AL2TECH/Project_Template/Rev_1/Outputs/PCB_Assembly/LEOLED_rev1_3D_BOTTOM.jpg

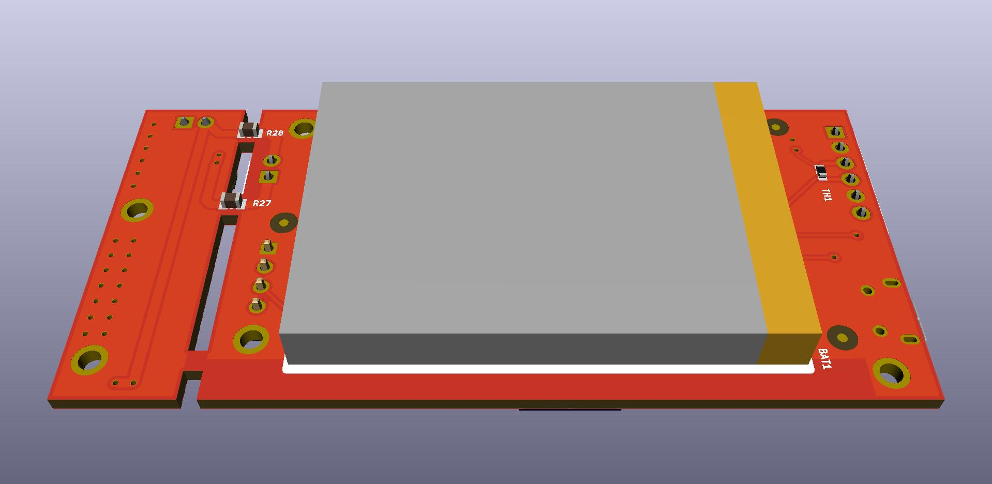
Rev_1/Outputs/PCB_Assembly/LEOLED_rev1_3D_BOTTOM.jpg
