AL2TECH/Project_Template/Rev_1/Outputs/PCB_Assembly/components_position_BOTTOM.csv

Reference | Package | X Position (mm) | Y Position (mm) | Rotation (Degrees) | Side
BAT1 | SMD | 37.03 | 21.33 | 0.0 | bottom
R27 | SMD | 71.0 | 24.7 | 0.0 | bottom
R28 | SMD | 70.9 | 35.9 | 0.0 | bottom
TH1 | SMD | 5.3 | 29.5 | 90.0 | bottom
