AL2TECH/Project_Template/Rev_1/Kicad/shapes3D/ABS07.step

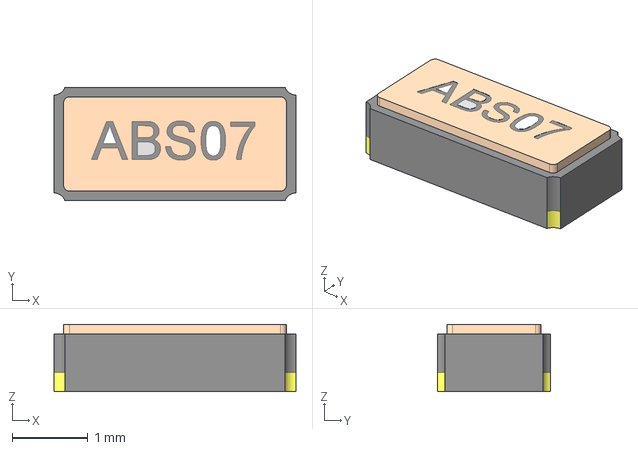
[picture p3: CAD file, 2019-05-30]
Rev_1/Kicad/shapes3D/ABS07.step
3.20 x 1.50 x 0.889 mm
