AL2TECH/Project_Template/Rev_1/Kicad/shapes3D/SOT-353_SC-70-5.step

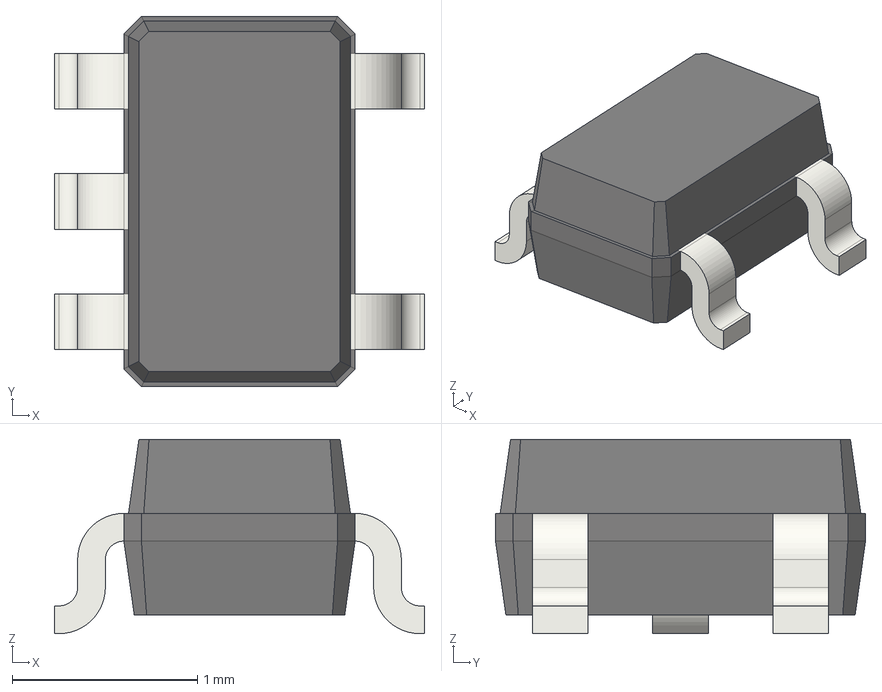
[picture p4: CAD file, 2019-05-30]
Rev_1/Kicad/shapes3D/SOT-353_SC-70-5.step
2.00 x 2.00 x 1.05 mm
