AL2TECH/Project_Template/Rev_1/Kicad/shapes3D/SOT-23-5.step

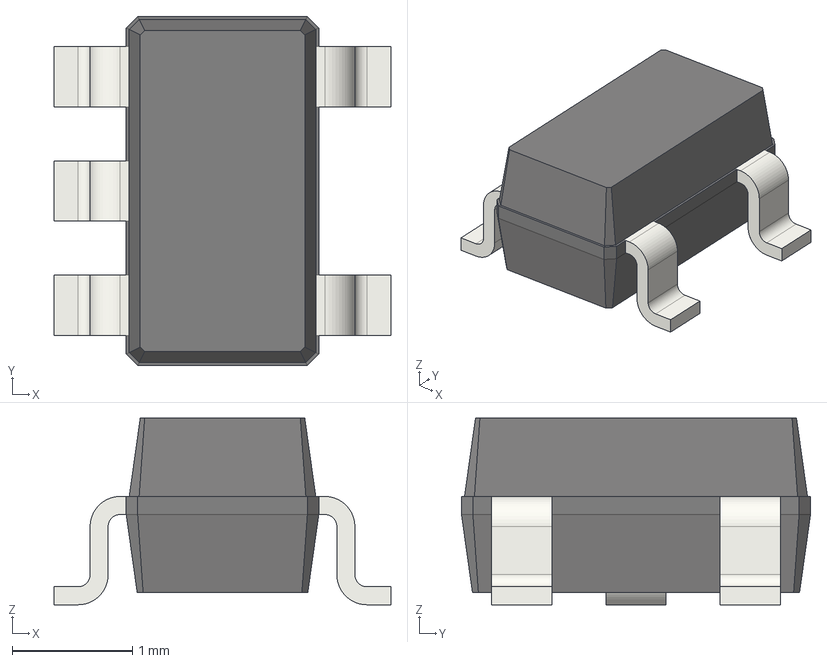
[picture p5: CAD file, 2019-05-30]
Rev_1/Kicad/shapes3D/SOT-23-5.step
2.80 x 2.90 x 1.55 mm
