AL2TECH/Project_Template/Rev_1/Kicad/shapes3D/D_SOD-123F.step

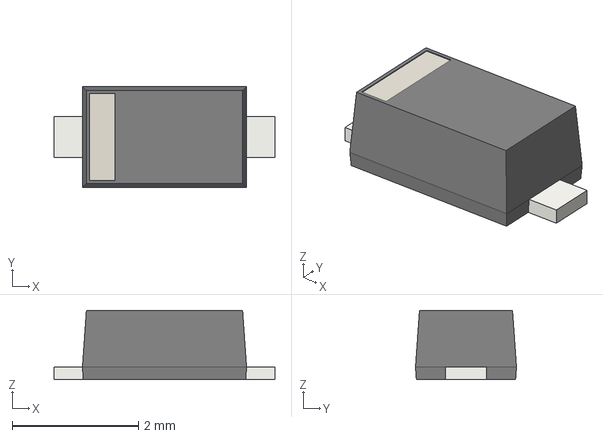
[picture p6: CAD file, 2019-05-30]
Rev_1/Kicad/shapes3D/D_SOD-123F.step
3.50 x 1.60 x 1.10 mm
