AL2TECH/Project_Template/Rev_1/Kicad/shapes3D/R_0603_1608Metric.step

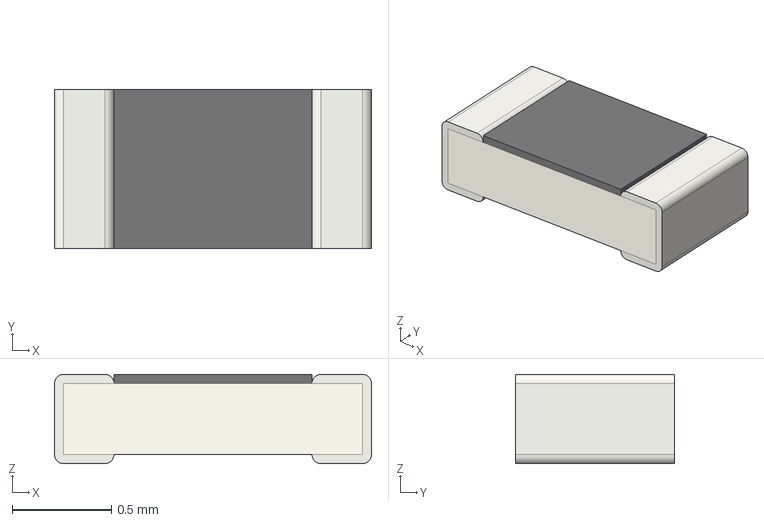
[picture p7: CAD file, 2019-05-30]
Rev_1/Kicad/shapes3D/R_0603_1608Metric.step
1.60 x 0.8 x 0.45 mm
