AL2TECH/Project_Template/Rev_1/Kicad/shapes3D/Lithium_battery_50x30x5.3.step

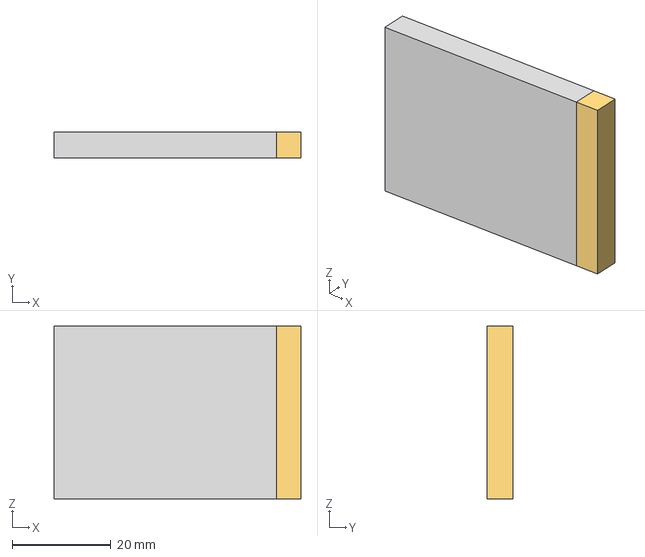
[picture p8: CAD file, 2019-05-30]
Rev_1/Kicad/shapes3D/Lithium_battery_50x30x5.3.step
50.0 x 5.30 x 35.0 mm
