AL2TECH/Project_Template/Rev_1/Kicad/shapes3D/C_1206_3216Metric.step

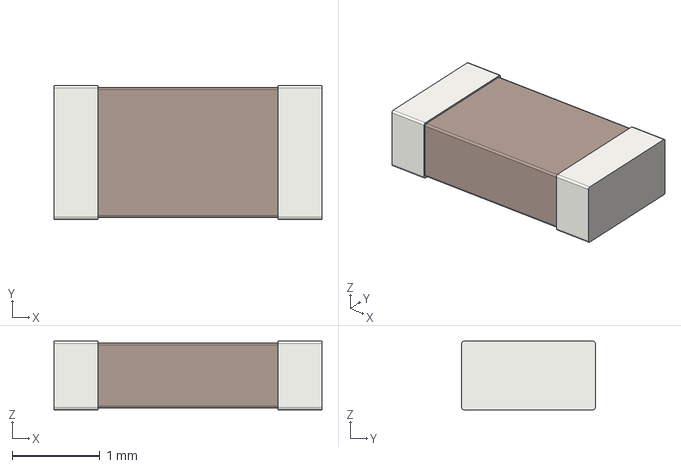
[picture p9: CAD file, 2019-05-30]
Rev_1/Kicad/shapes3D/C_1206_3216Metric.step
3.05 x 1.52 x 0.78 mm
