AL2TECH/Project_Template/Rev_1/Kicad/shapes3D/C_0805_2012Metric.step

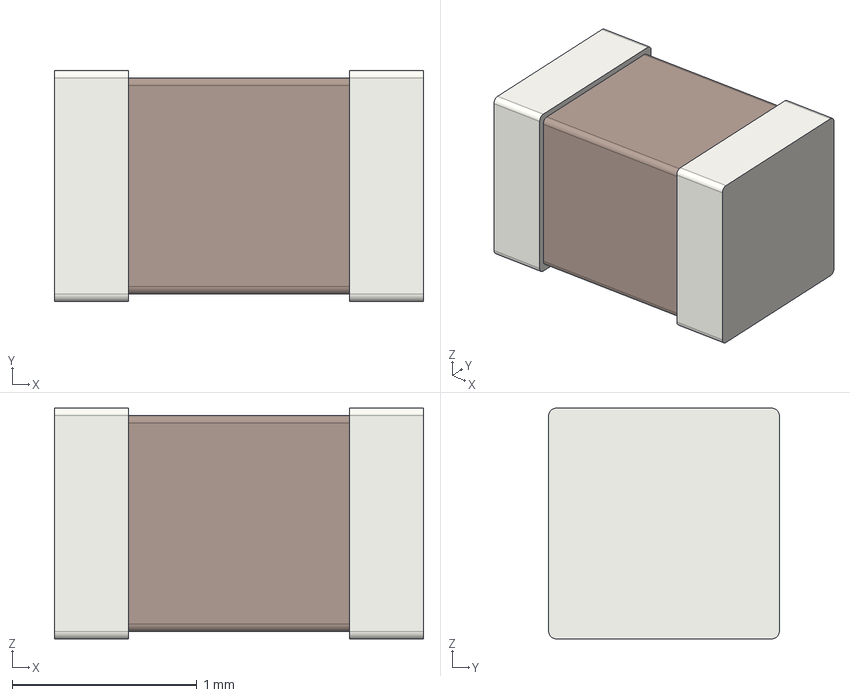
[picture p11: CAD file, 2019-05-30]
Rev_1/Kicad/shapes3D/C_0805_2012Metric.step
2.00 x 1.25 x 1.25 mm
