AL2TECH/Project_Template/Rev_1/Kicad/shapes3D/WSON-20_2x3mm.step

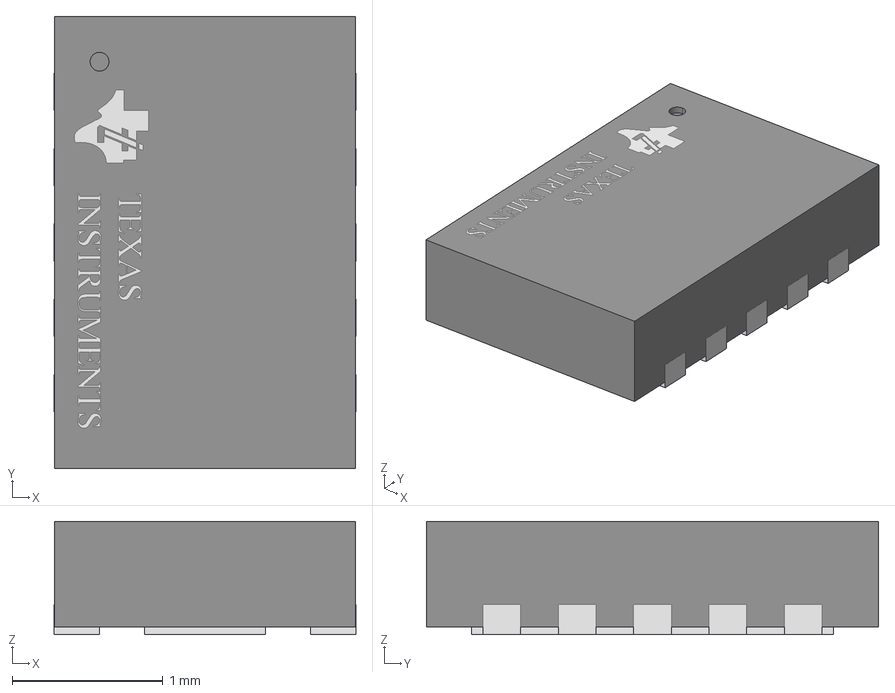
[picture p12: CAD file, 2019-05-30]
Rev_1/Kicad/shapes3D/WSON-20_2x3mm.step
2.00 x 3.00 x 0.75 mm
