AL2TECH/Project_Template/Rev_1/Kicad/shapes3D/LED_0603_Side_Mounted.step

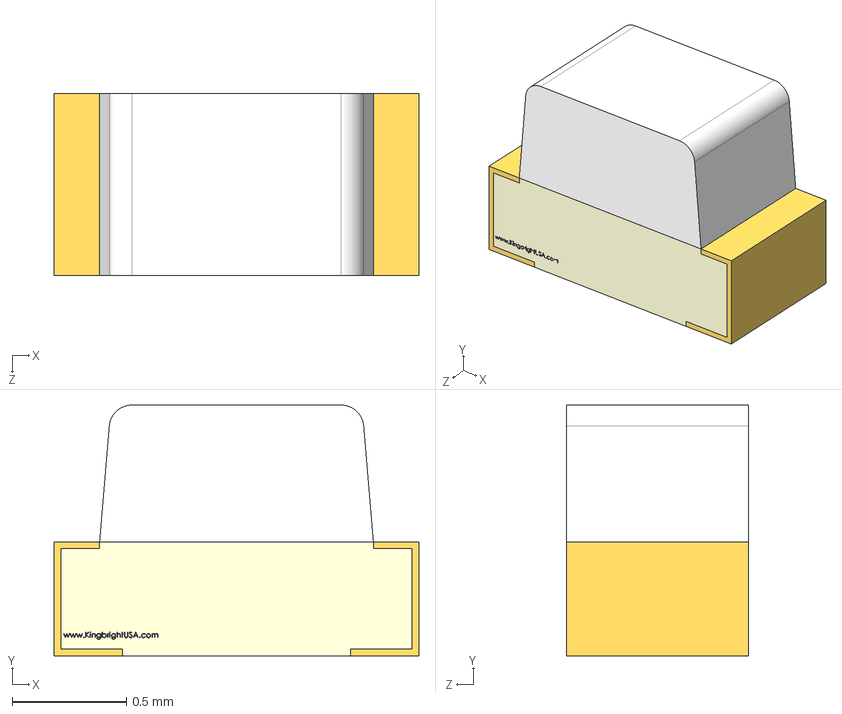
[picture p14: CAD file, 2019-05-30]
Rev_1/Kicad/shapes3D/LED_0603_Side_Mounted.step
1.60 x 1.10 x 0.8 mm
