AL2TECH/Project_Template/Rev_1/Kicad/shapes3D/C_0402_1005Metric.step

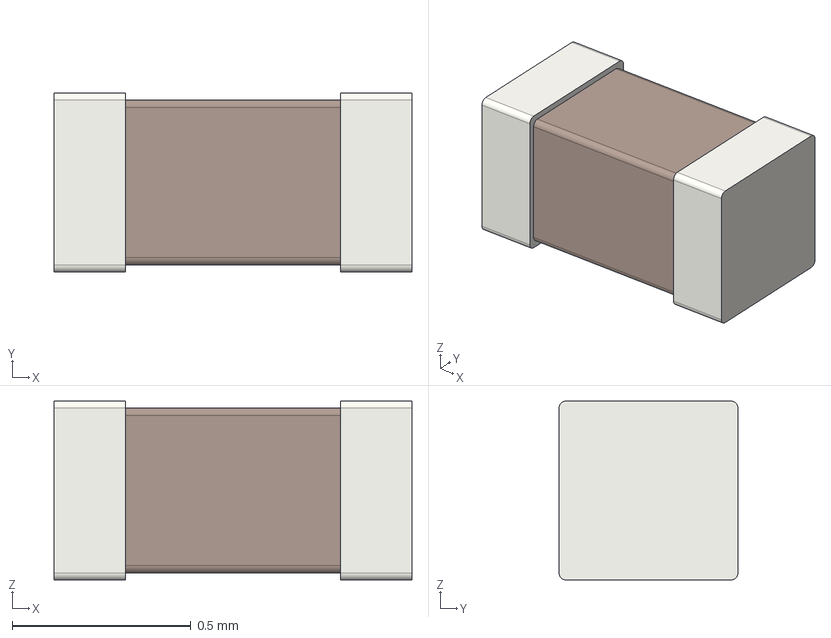
[picture p15: CAD file, 2019-05-30]
Rev_1/Kicad/shapes3D/C_0402_1005Metric.step
1.00 x 0.5 x 0.5 mm
