AL2TECH/Project_Template/Rev_1/Kicad/shapes3D/Pin_Header_Straight_2x05_Pitch1.27mm_SMD.step

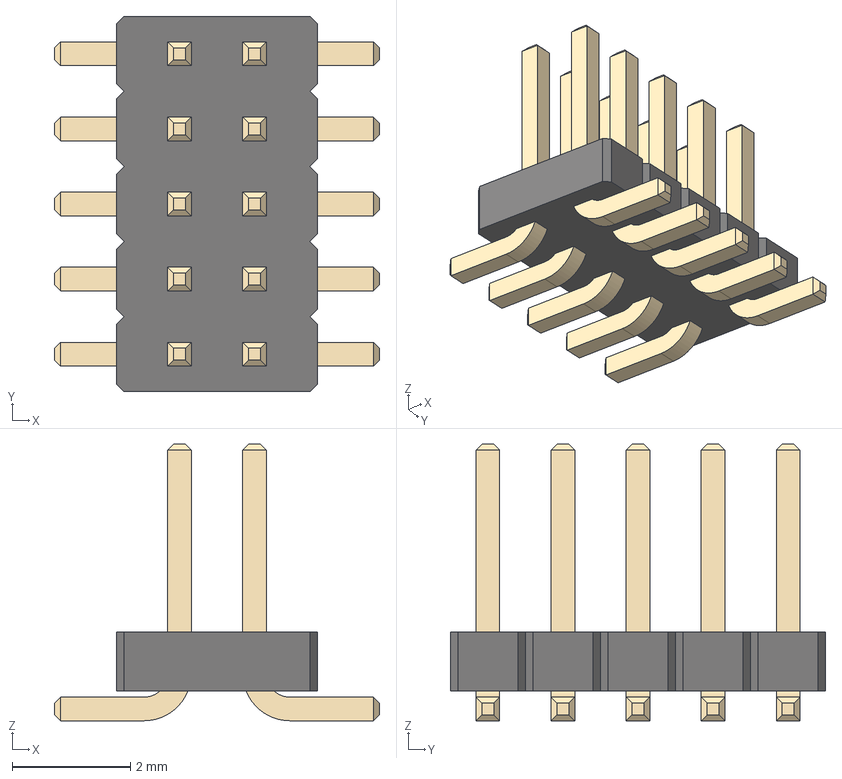
[picture p16: CAD file, 2019-05-30]
Rev_1/Kicad/shapes3D/Pin_Header_Straight_2x05_Pitch1.27mm_SMD.step
5.50 x 6.35 x 4.68 mm
