AL2TECH/Project_Template/Rev_1/Kicad/shapes3D/L_Wurth_5030.step

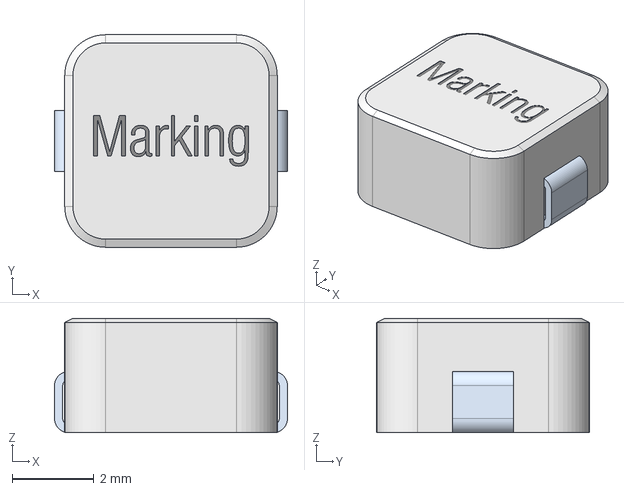
[picture p17: CAD file, 2019-05-30]
Rev_1/Kicad/shapes3D/L_Wurth_5030.step
5.70 x 5.20 x 2.80 mm
