AL2TECH/Project_Template/Rev_1/Kicad/shapes3D/Pin_Header_Straight_1x04_Pitch2.54mm.step

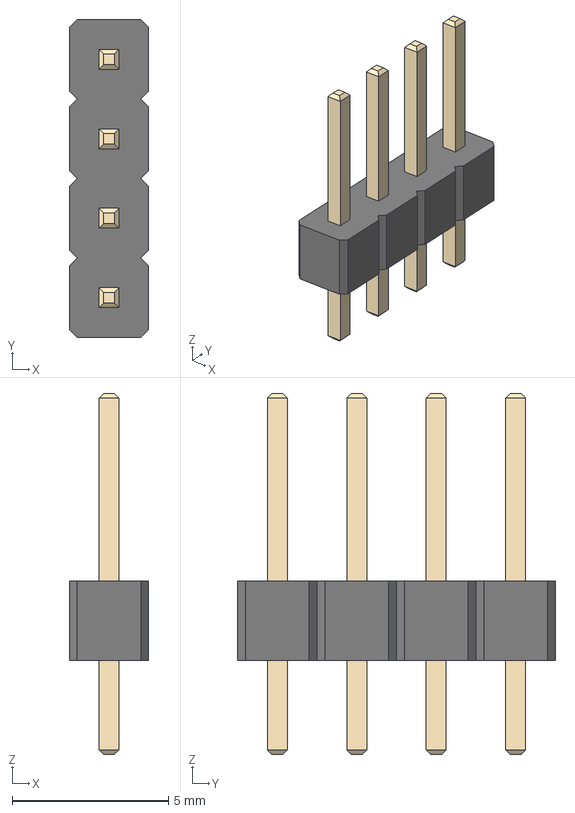
[picture p18: CAD file, 2019-05-30]
Rev_1/Kicad/shapes3D/Pin_Header_Straight_1x04_Pitch2.54mm.step
2.54 x 10.2 x 11.5 mm
