AL2TECH/Project_Template/Rev_1/Kicad/shapes3D/USB_Molex_1050170001.step

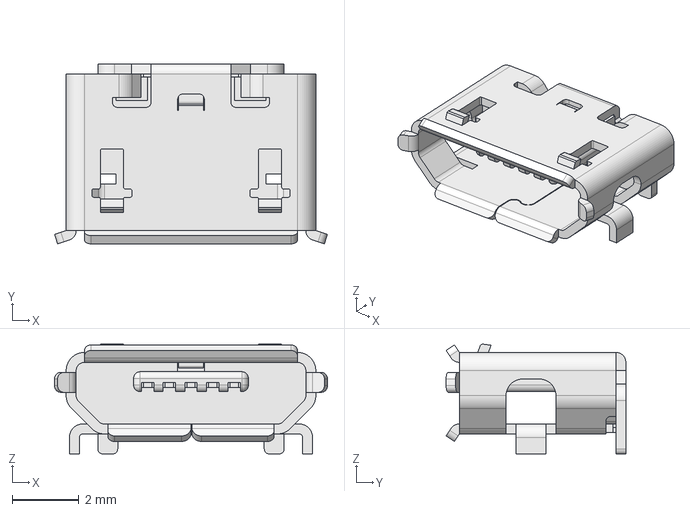
[picture p19: CAD file, 2019-05-30]
Rev_1/Kicad/shapes3D/USB_Molex_1050170001.step
8.20 x 5.40 x 3.30 mm
