AL2TECH/Project_Template/Rev_1/Kicad/shapes3D/Cree_XLM.step

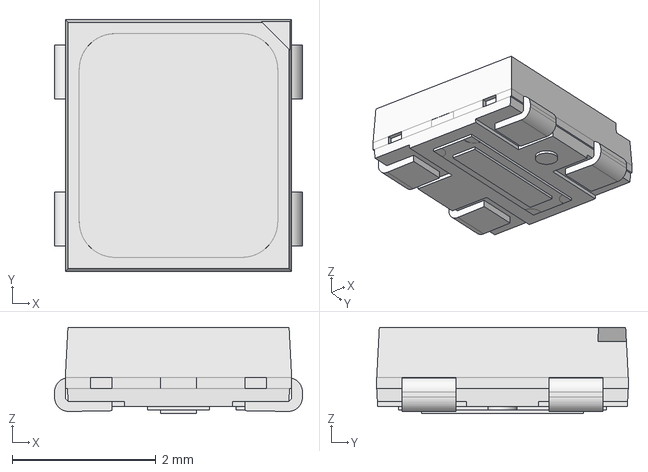
[picture p20: CAD file, 2019-05-30]
Rev_1/Kicad/shapes3D/Cree_XLM.step
3.45 x 3.50 x 1.20 mm
