AL2TECH/Project_Template/Rev_1/Outputs/PCB_Manufacturing/LEOLED_rev1-Fab_Drawings.pdf

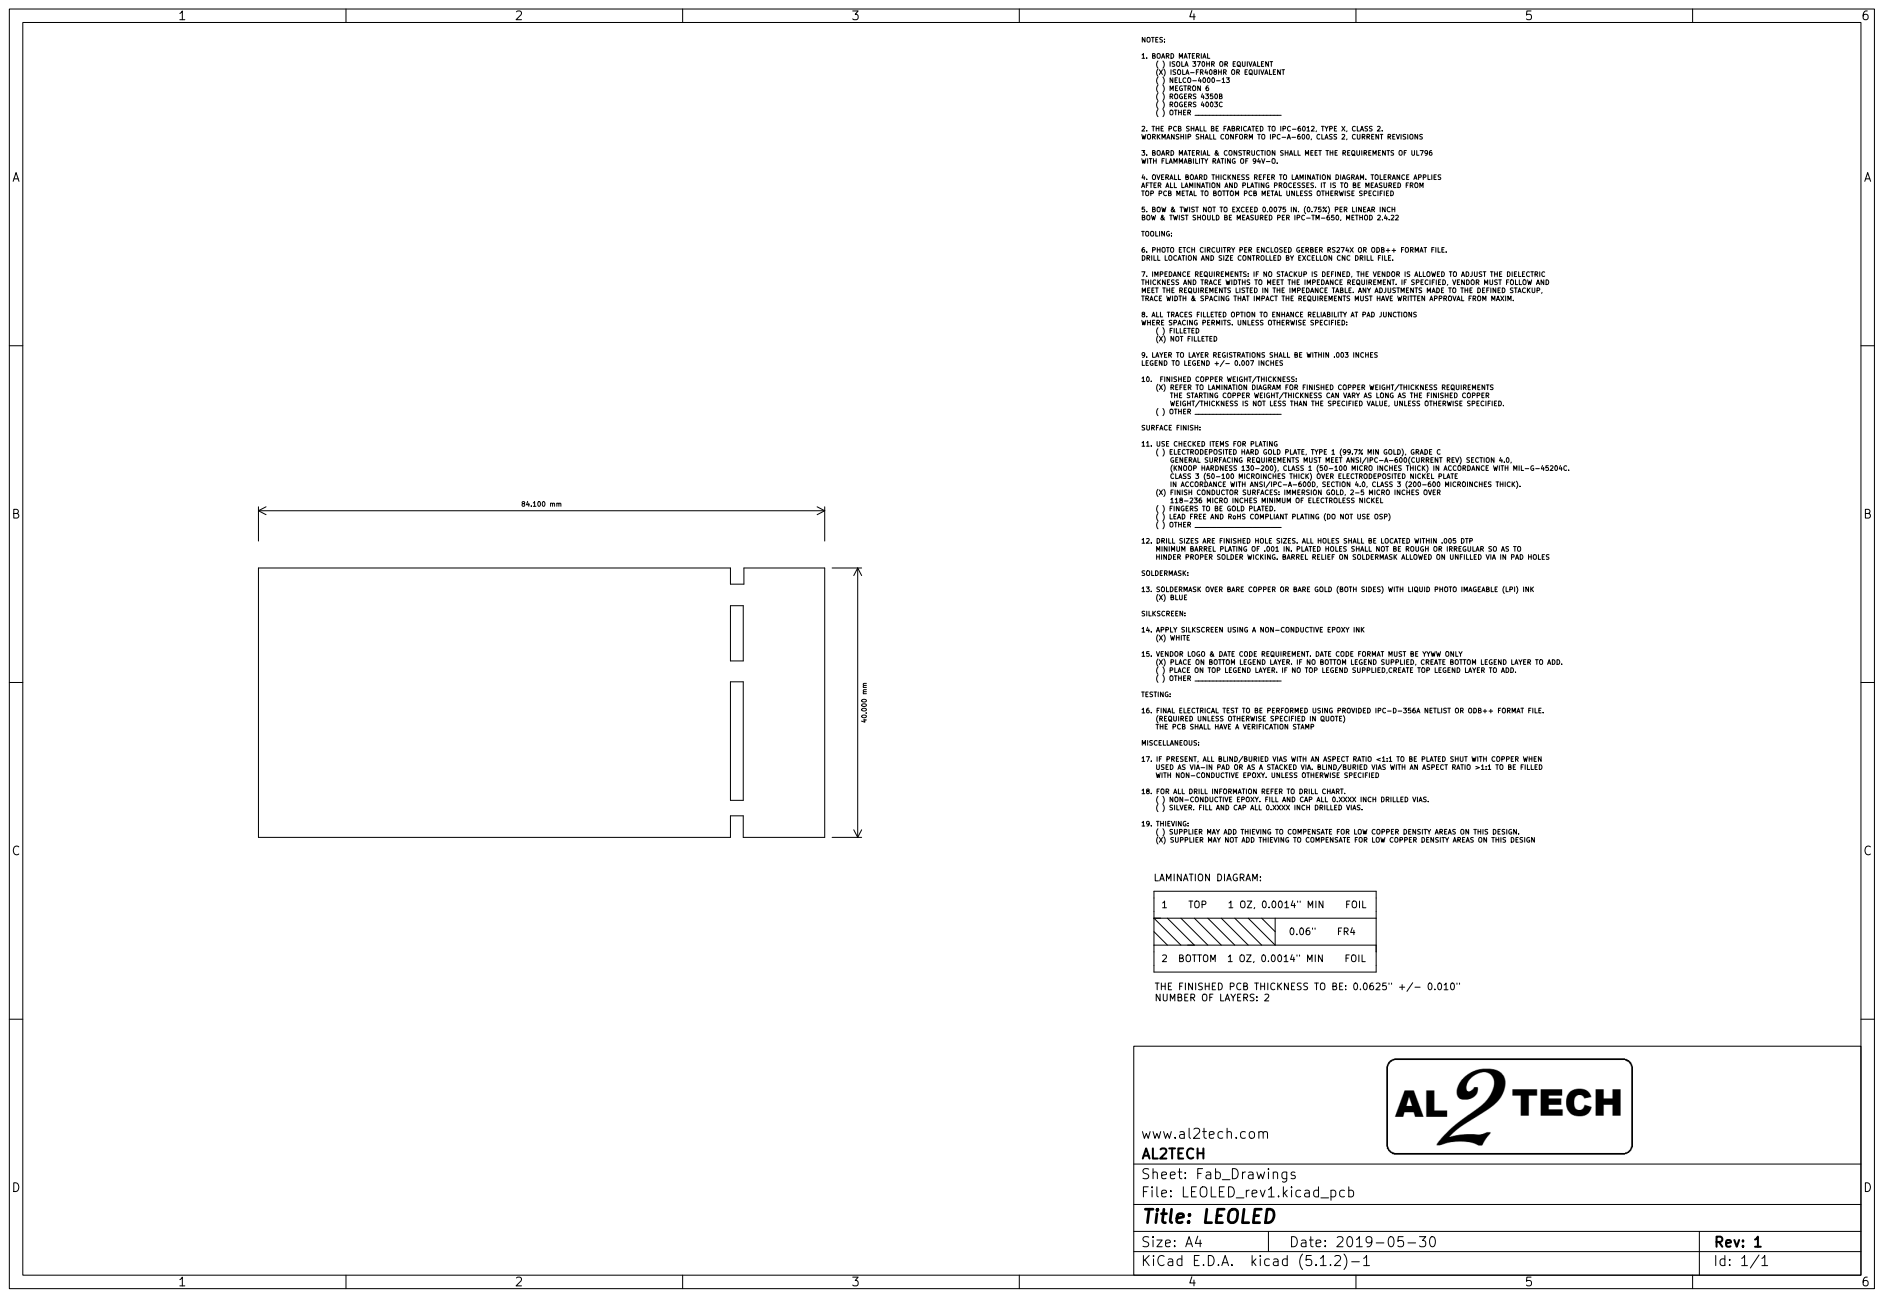
[picture p21: page 1]

2. THE PCB SHALL BE FABRICATED TO IPC-6012, TYPE X, CLASS 2. WORKMANSHIP SHALL CONFORM TO IPC-A-600, CLASS 2, CURRENT REVISIONS

3. BOARD MATERIAL & CONSTRUCTION SHALL MEET THE REQUIREMENTS OF UL796 WITH FLAMMABILITY RATING OF 94V-O. 4. OVERALL BOARD THICKNESS REFER TO LAMINATION DIAGRAM. TOLERANCE APPLIES AFTER ALL LAMINATION AND PLATING PROCESSES. IT IS TO BE MEASURED FROM

TOP PCB METAL TO BOTTOM PCB METAL UNLESS OTHERWISE SPECIFIED

5. BOW & TWIST NOT TO EXCEED 0.0075 IN. (0.75%) PER LINEAR INCH
BOW & TWIST SHOULD BE MEASURED PER IPC-TM-650, METHOD 2.4.22 TOOLING: 6. PHOTO ETCH CIRCUITRY PER ENCLOSED GERBER RS274X OR ODB++ FORMAT FILE. DRILL LOCATION AND SIZE CONTROLLED BY EXCELLON CNC DRILL FILE. 7. IMPEDANCE REQUIREMENTS: IF NO STACKUP IS DEFINED, THE VENDOR IS ALLOWED TO ADJUST THE DIELECTRIC

THICKNESS AND TRACE WIDTHS TO MEET THE IMPEDANCE REQUIREMENT. IF SPECIFIED, VENDOR MUST FOLLOW AND MEET THE REQUIREMENTS LISTED IN THE IMPEDANCE TABLE. ANY ADJUSTMENTS MADE TO THE DEFINED STACKUP, TRACE WIDTH & SPACING THAT IMPACT THE REQUIREMENTS MUST HAVE WRITTEN APPROVAL FROM MAXIM. 8. ALL TRACES FILLETED OPTION TO ENHANCE RELIABILITY AT PAD JUNCTIONS WHERE SPACING PERMITS. UNLESS OTHERWISE SPECIFIED:

9. LAYER TO LAYER REGISTRATIONS SHALL BE WITHIN .003 INCHES
LEGEND TO LEGEND +/- 0.007 INCHES

10. FINISHED COPPER WEIGHT/THICKNESS:
(X) REFER TO LAMINATION DIAGRAM FOR FINISHED COPPER WEIGHT/THICKNESS REQUIREMENTS
THE STARTING COPPER WEIGHT/THICKNESS CAN VARY AS LONG AS THE FINISHED COPPER
WEIGHT/THICKNESS IS NOT LESS THAN THE SPECIFIED VALUE, UNLESS OTHERWISE SPECIFIED.
( ) OTHER ________________________ SURFACE FINISH: 11. USE CHECKED ITEMS FOR PLATING

( ) ELECTRODEPOSITED HARD GOLD PLATE, TYPE 1 (99.7% MIN GOLD), GRADE C
GENERAL SURFACING REQUIREMENTS MUST MEET ANSI/IPC-A-600(CURRENT REV) SECTION 4.0,
(KNOOP HARDNESS 130-200), CLASS 1 (50-100 MICRO INCHES THICK) IN ACCORDANCE WITH MIL-G-45204C.
CLASS 3 (50-100 MICROINCHES THICK) OVER ELECTRODEPOSITED NICKEL PLATE
IN ACCORDANCE WITH ANSI/IPC-A-600D, SECTION 4.0, CLASS 3 (200-600 MICROINCHES THICK).
(X) FINISH CONDUCTOR SURFACES: IMMERSION GOLD, 2-5 MICRO INCHES OVER
118-236 MICRO INCHES MINIMUM OF ELECTROLESS NICKEL
( ) FINGERS TO BE GOLD PLATED.
( ) LEAD FREE AND RoHS COMPLIANT PLATING (DO NOT USE OSP)
( ) OTHER ________________________

12. DRILL SIZES ARE FINISHED HOLE SIZES. ALL HOLES SHALL BE LOCATED WITHIN .005 DTP
MINIMUM BARREL PLATING OF .001 IN. PLATED HOLES SHALL NOT BE ROUGH OR IRREGULAR SO AS TO
HINDER PROPER SOLDER WICKING. BARREL RELIEF ON SOLDERMASK ALLOWED ON UNFILLED VIA IN PAD HOLES

SOLDERMASK: 13. SOLDERMASK OVER BARE COPPER OR BARE GOLD (BOTH SIDES) WITH LIQUID PHOTO IMAGEABLE (LPI) INK

SILKSCREEN: 14. APPLY SILKSCREEN USING A NON-CONDUCTIVE EPOXY INK

15. VENDOR LOGO & DATE CODE REQUIREMENT. DATE CODE FORMAT MUST BE YYWW ONLY
(X) PLACE ON BOTTOM LEGEND LAYER. IF NO BOTTOM LEGEND SUPPLIED, CREATE BOTTOM LEGEND LAYER TO ADD.
( ) PLACE ON TOP LEGEND LAYER. IF NO TOP LEGEND SUPPLIED,CREATE TOP LEGEND LAYER TO ADD.
( ) OTHER ________________________ TESTING: 16. FINAL ELECTRICAL TEST TO BE PERFORMED USING PROVIDED IPC-D-356A NETLIST OR ODB++ FORMAT FILE.

(REQUIRED UNLESS OTHERWISE SPECIFIED IN QUOTE)
THE PCB SHALL HAVE A VERIFICATION STAMP MISCELLANEOUS: 17. IF PRESENT, ALL BLIND/BURIED VIAS WITH AN ASPECT RATIO <1:1 TO BE PLATED SHUT WITH COPPER WHEN

USED AS VIA-IN PAD OR AS A STACKED VIA. BLIND/BURIED VIAS WITH AN ASPECT RATIO >1:1 TO BE FILLED
WITH NON-CONDUCTIVE EPOXY. UNLESS OTHERWISE SPECIFIED

18. FOR ALL DRILL INFORMATION REFER TO DRILL CHART.
( ) NON-CONDUCTIVE EPOXY. FILL AND CAP ALL 0.XXXX INCH DRILLED VIAS.
( ) SILVER. FILL AND CAP ALL 0.XXXX INCH DRILLED VIAS. 19. THIEVING:

( ) SUPPLIER MAY ADD THIEVING TO COMPENSATE FOR LOW COPPER DENSITY AREAS ON THIS DESIGN.
(X) SUPPLIER MAY NOT ADD THIEVING TO COMPENSATE FOR LOW COPPER DENSITY AREAS ON THIS DESIGN

1 TOP 1 OZ, 0.0014" MIN FOIL

2 BOTTOM 1 OZ, 0.0014" MIN FOIL
