AL2TECH/Project_Template/Rev_1/Outputs/PCB_Assembly/LEOLED_rev1-Assembly_BOTTOM.pdf

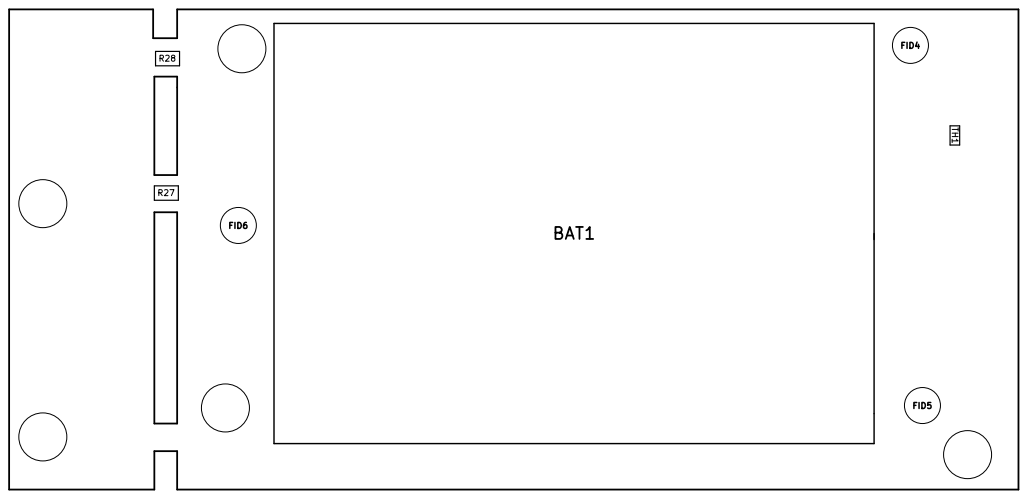
[picture p22: page 1]
