AL2TECH/Project_Template/Rev_1/Outputs/PCB_Assembly/LEOLED_rev1-Assembly_TOP.pdf

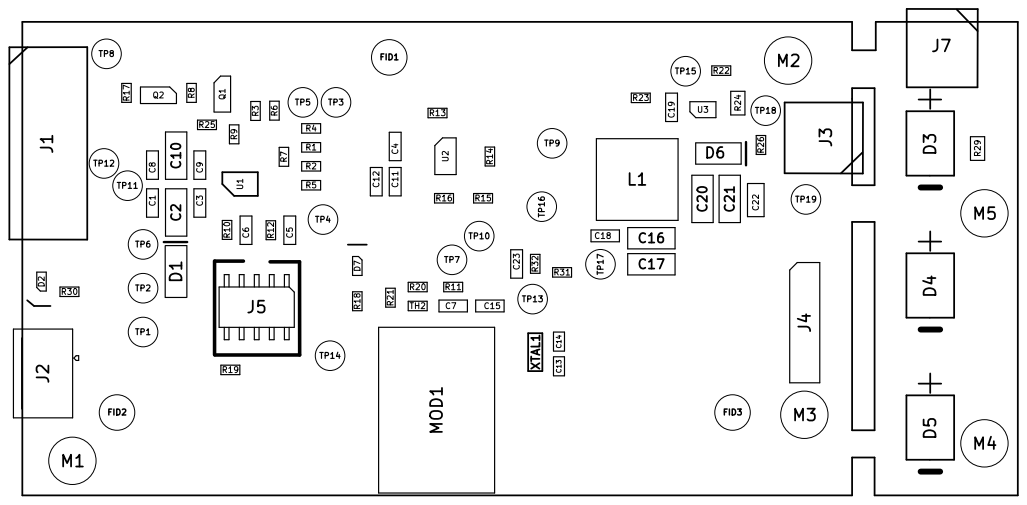
[picture p23: page 1]
