AL2TECH/Project_Template/Rev_1/Outputs/PDF/LEOLED_rev1_SCHEMATIC.pdf

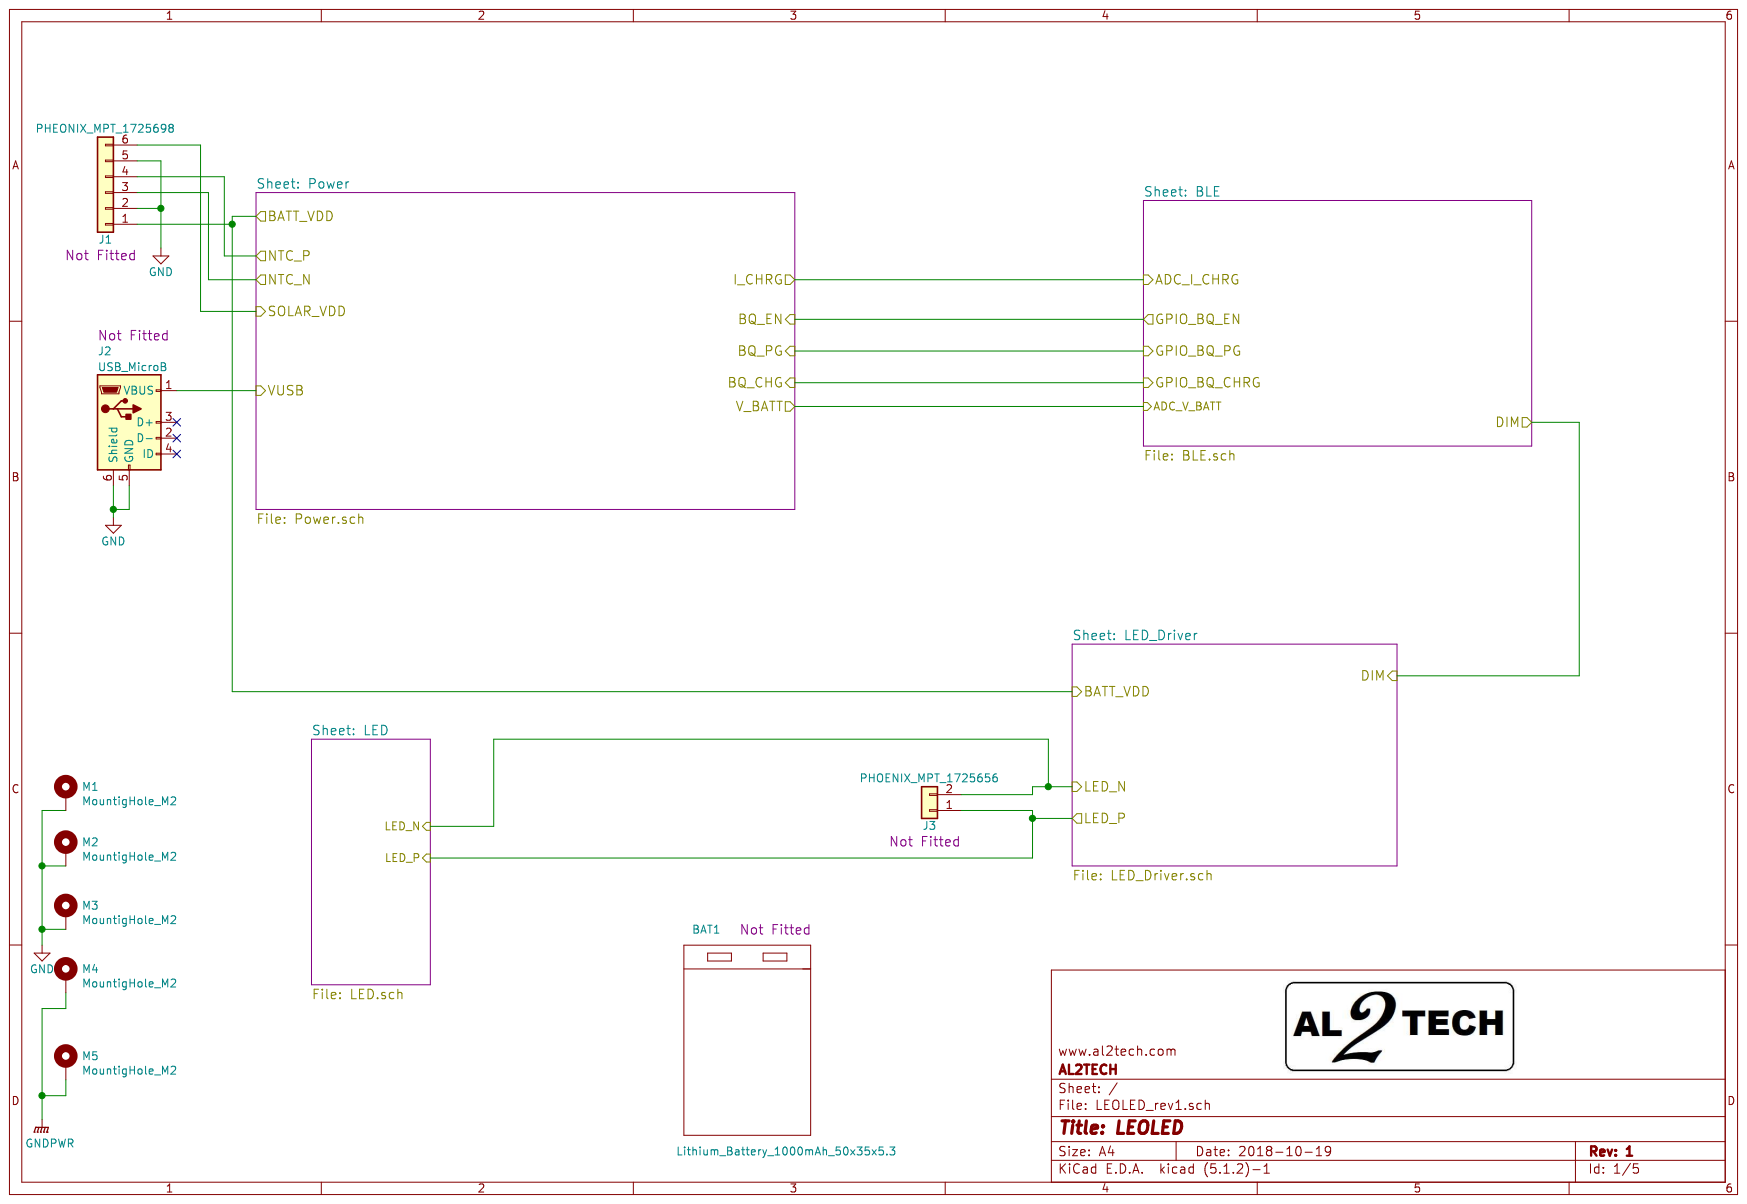
[picture p24: page 1]

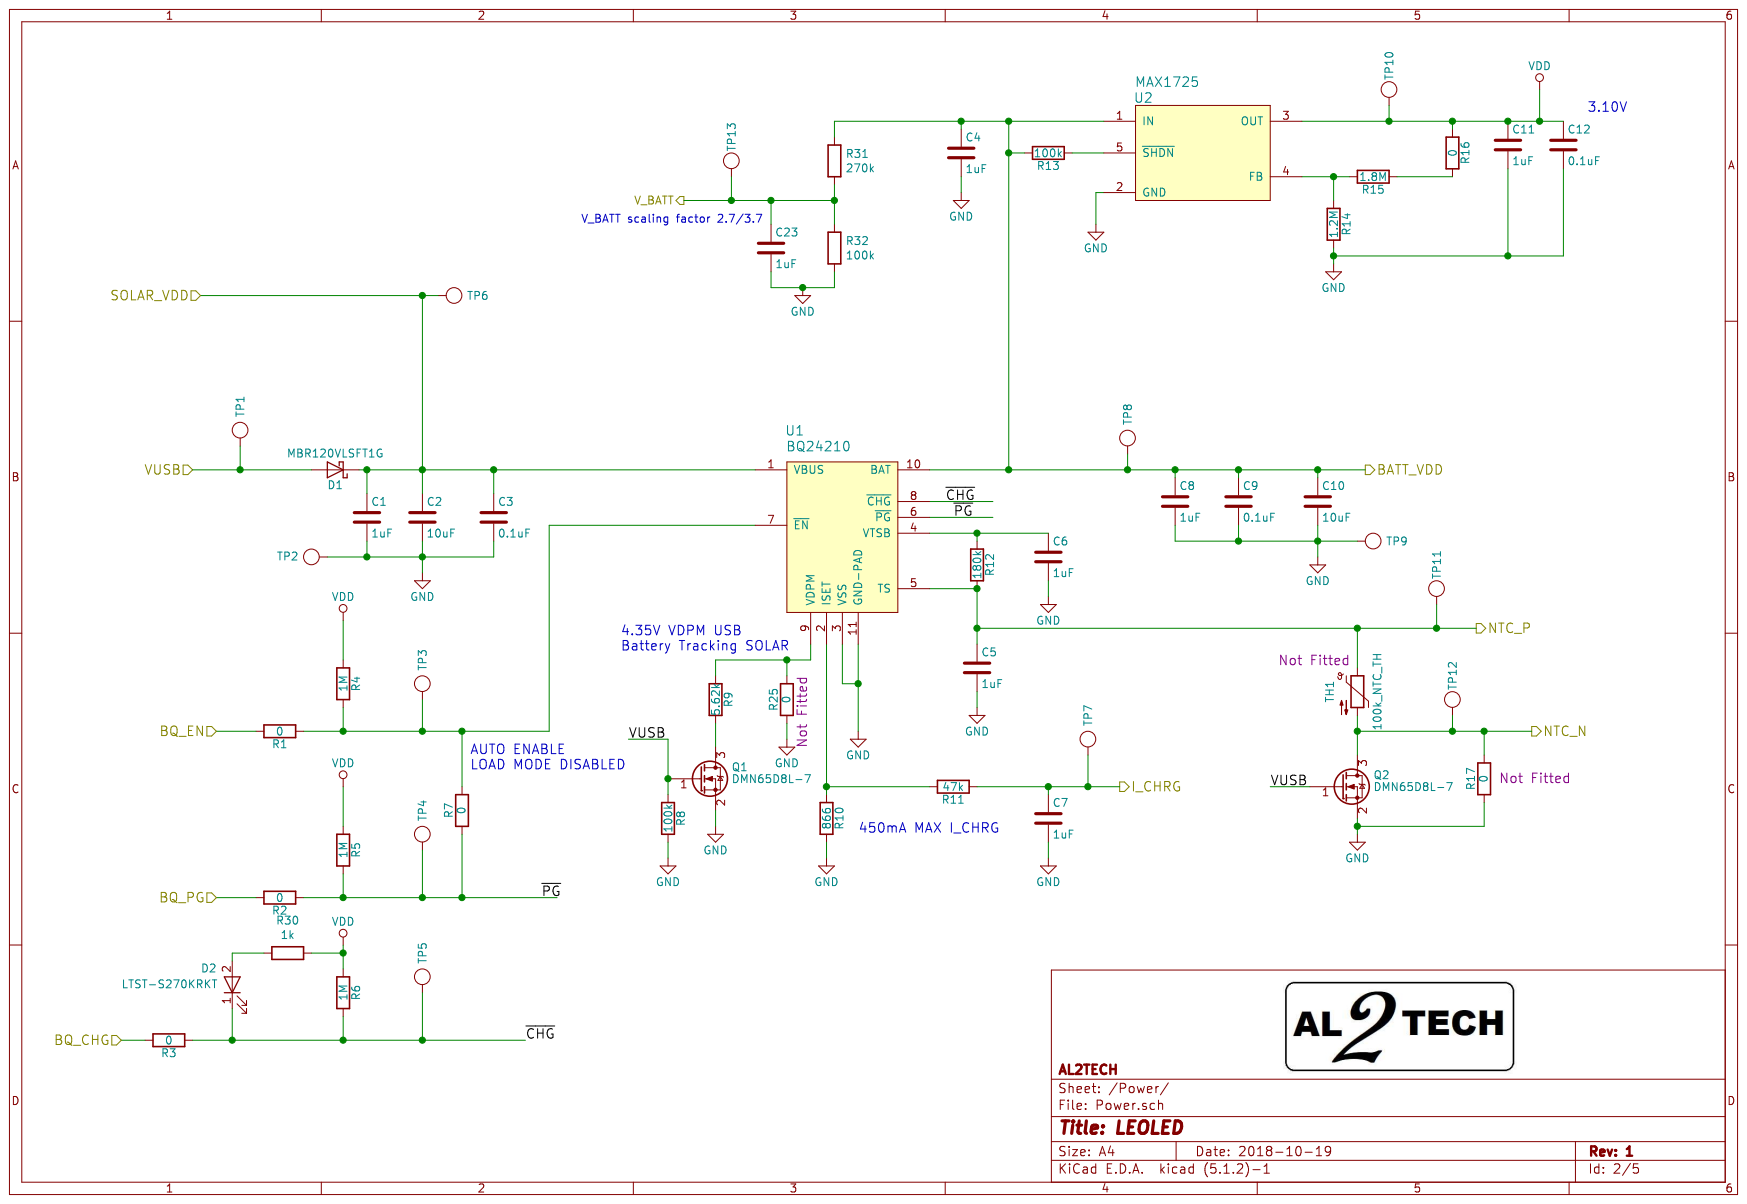
[picture p25: page 2]

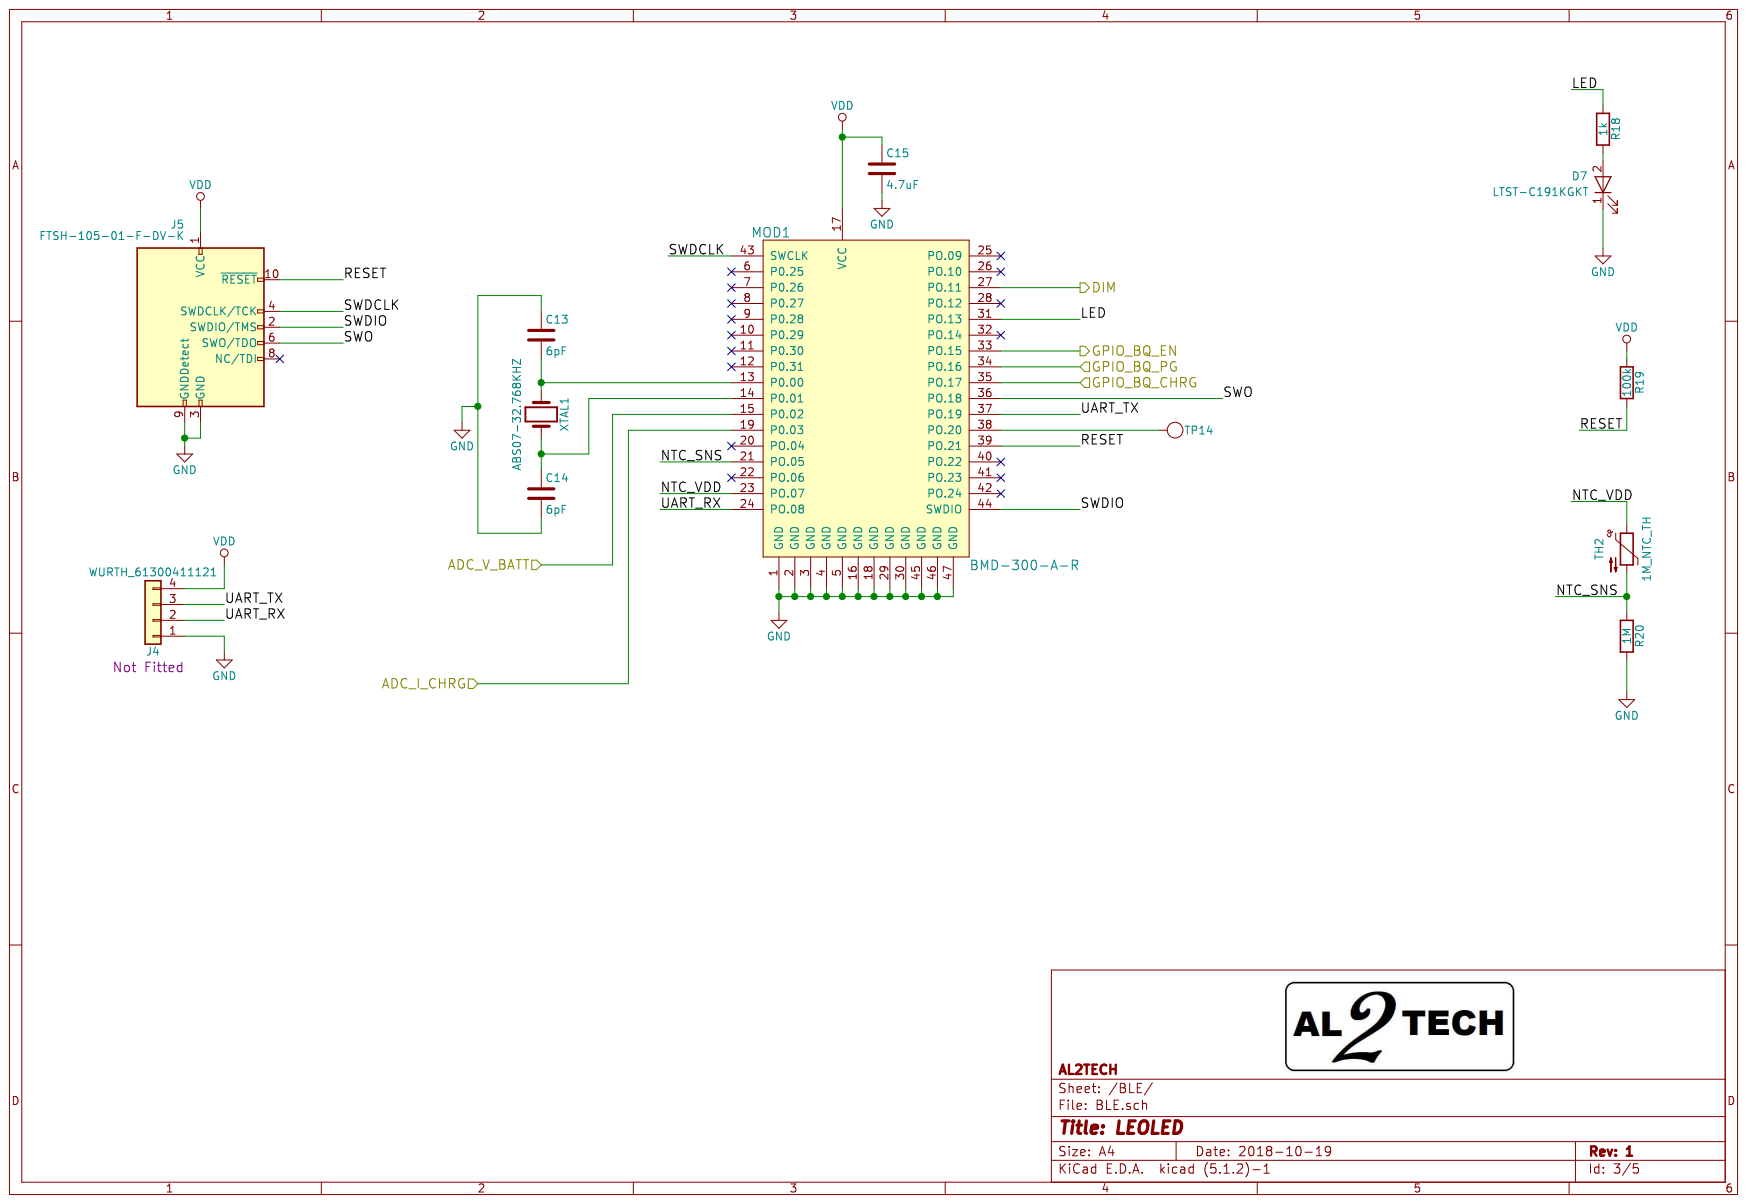
[picture p26: page 3]

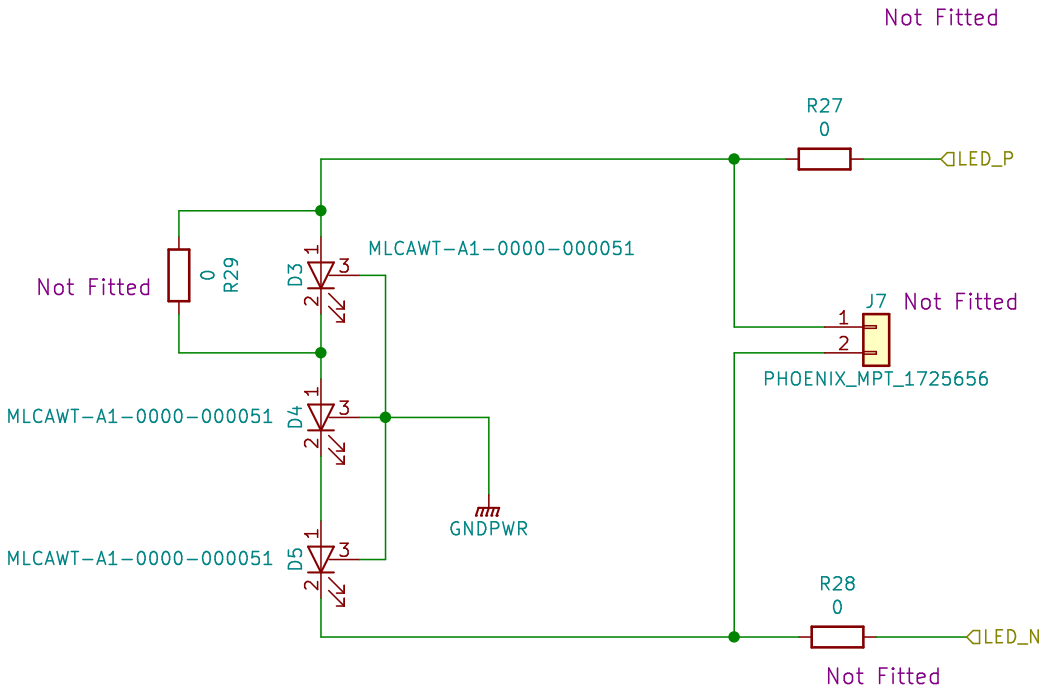
[picture p27: page 4]

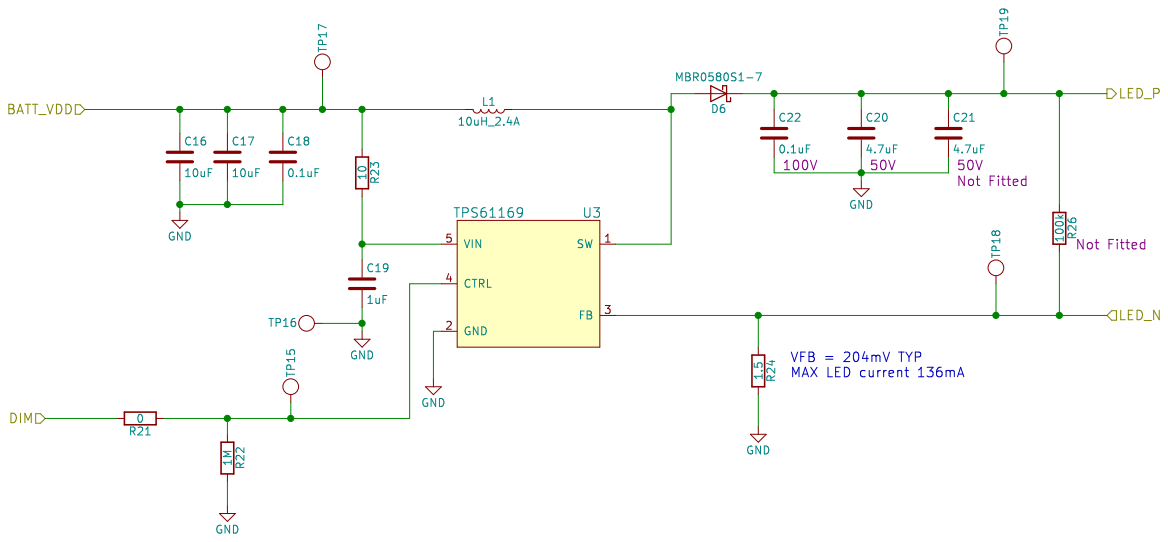
[picture p28: page 5]
