AL2TECH/Project_Template/Rev_1/Kicad/LEOLED_rev1.kicad_pcb

## KiCad design Rev_1/Kicad/LEOLED_rev1.kicad_pcb (2019-05-30)

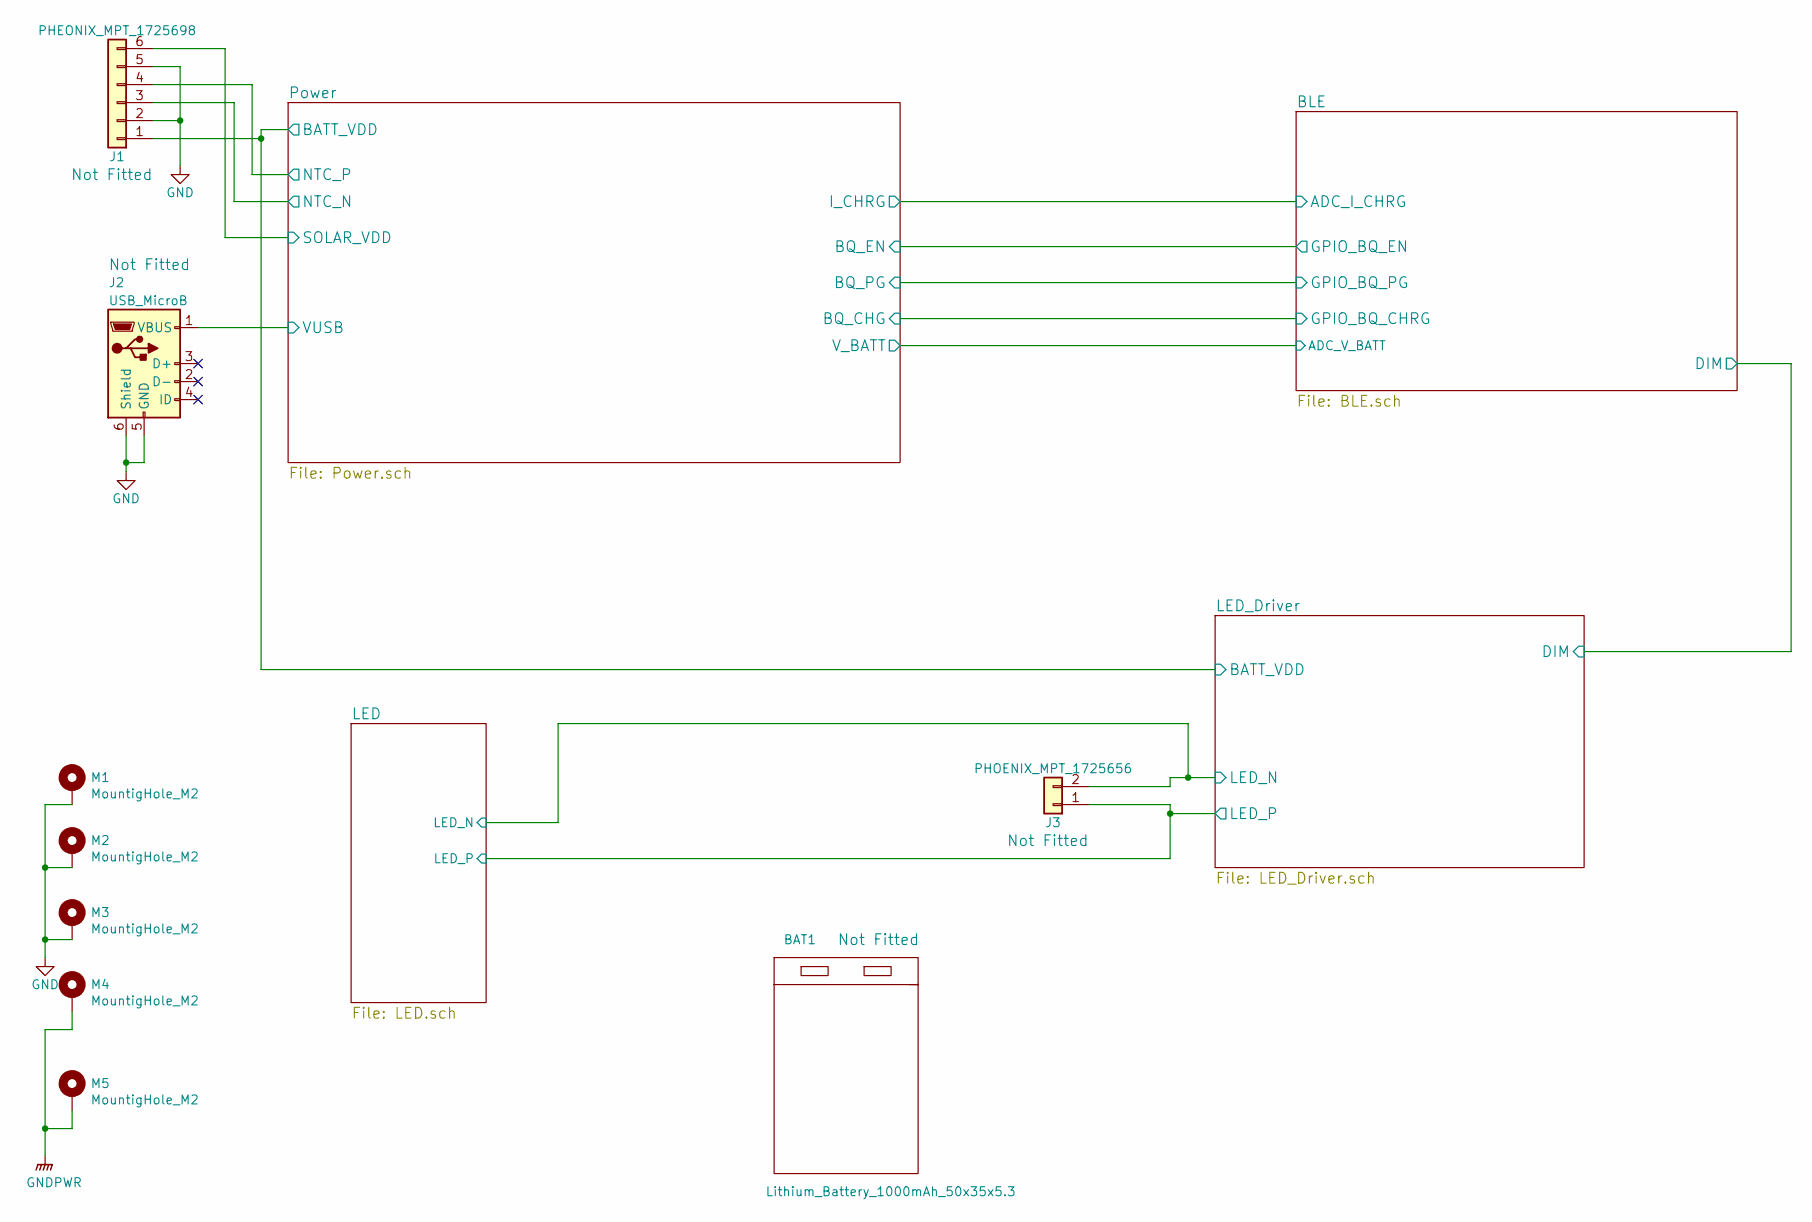
[picture p39: schematic LEOLED_rev1.sch, LEOLED]

Parts:
BAT1: Lithium_Battery_1000mAh_50x35x5.3; Lithium_battery_50x30x5.3; Rating 1000mAh, 3.7V; Tolerance NA; Manufacturer PN 523450
J1: PHEONIX_MPT_1725698; TerminalBlock_Pheonix_MPT-2.54mm_6pol; Rating 125V, 6A; Tolerance NA; Manufacturer PN 1725698
J2: USB_MicroB; USB_Micro-B_Molex-105017-0001; Rating NA; Tolerance NA; Manufacturer PN 1050170001
J3: PHOENIX_MPT_1725656; TerminalBlock_Pheonix_MPT-2.54mm_2pol; Rating 6A, 125V; Tolerance NA; Manufacturer PN 1725656
M1, M2, M3, M4, M5: MountigHole_M2; MountingHole_2.2mm_M2_ISO7380_Pad; Rating NA; Tolerance NA; Manufacturer PN NA

Connections:
/LED/LED_N: J3.2; also elsewhere on the board
/LED_Driver/BATT_VDD: J1.1; also elsewhere on the board
/Power/NTC_N: J1.3; also elsewhere on the board
/Power/NTC_P: J1.4; also elsewhere on the board
/Power/SOLAR_VDD: J1.6; also elsewhere on the board
/Power/VUSB: J2.1 (VBUS); also elsewhere on the board
GNDPWR: M4.1, M5.1; also elsewhere on the board

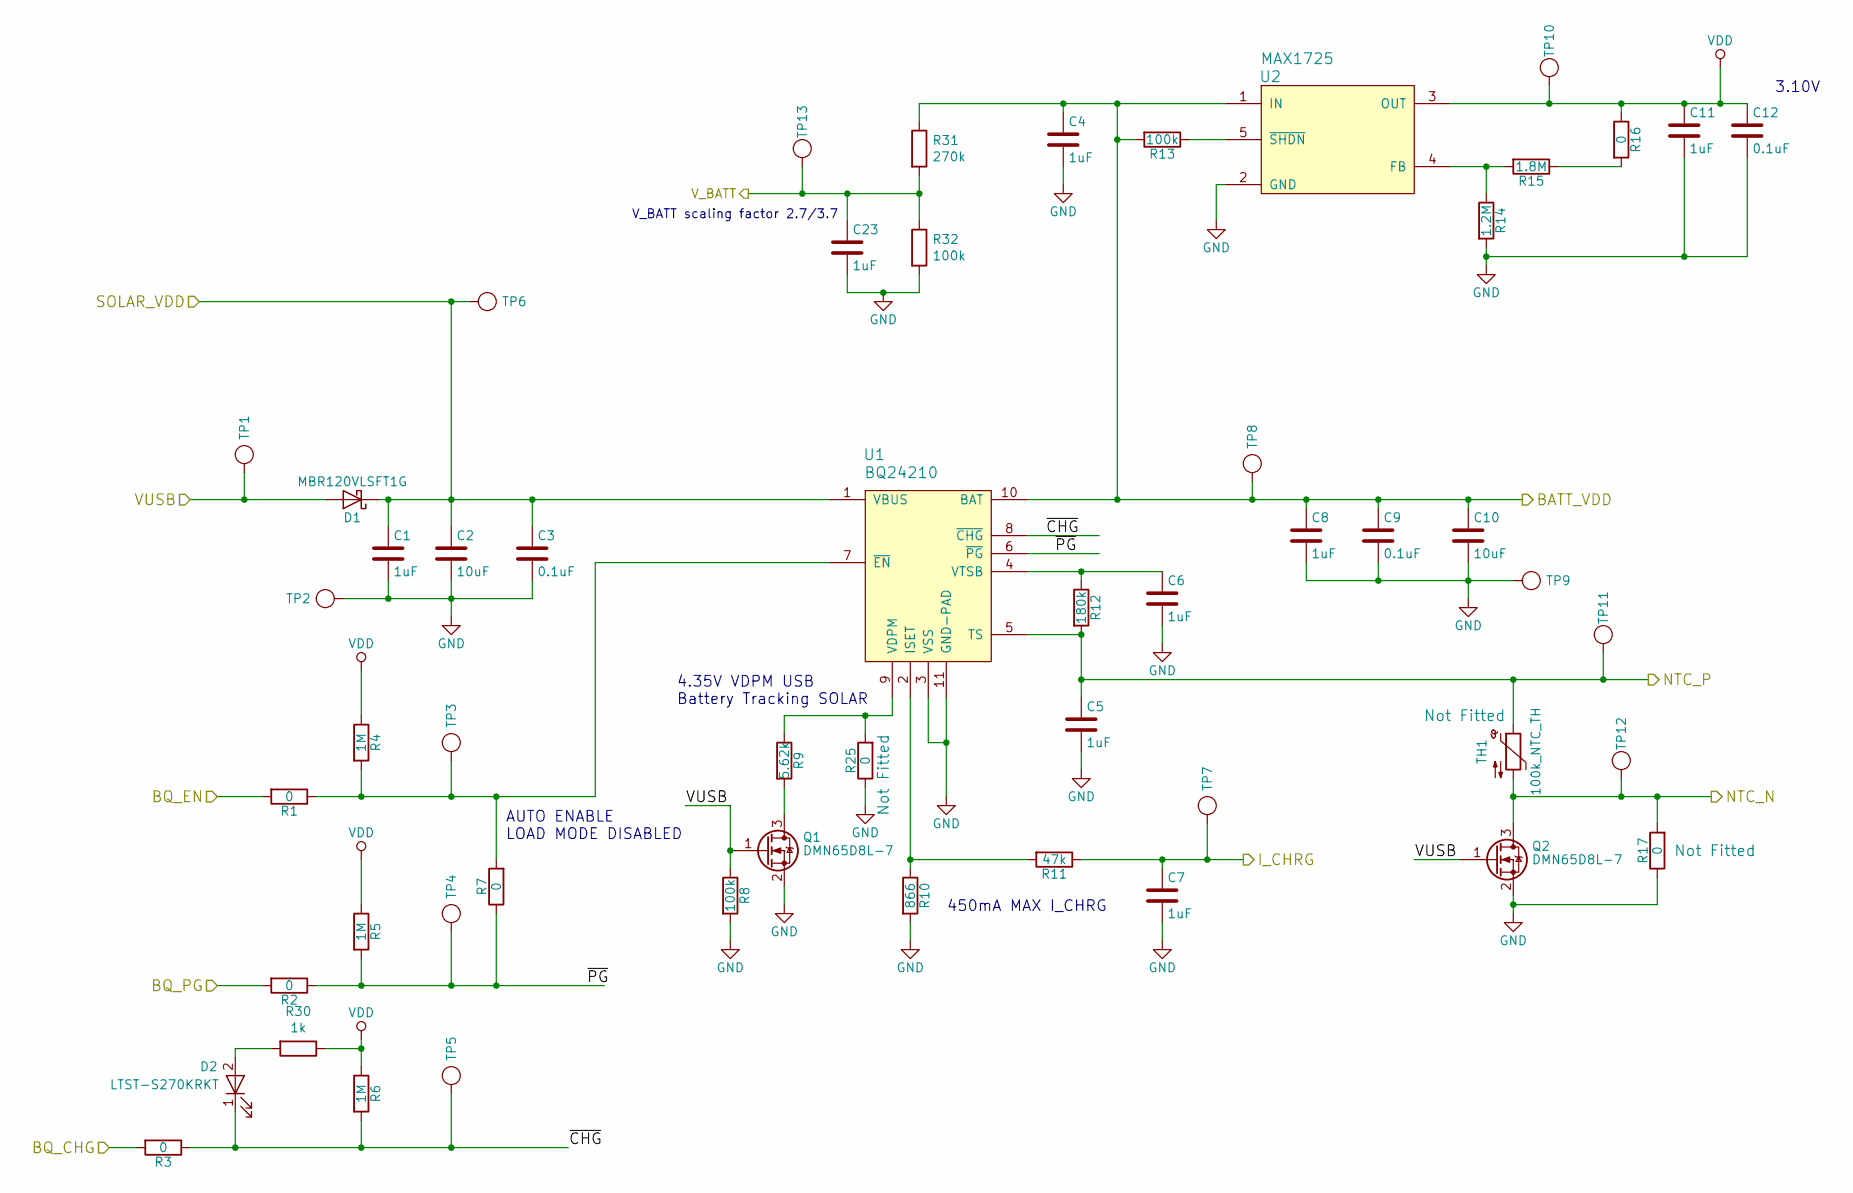
[picture p40: schematic Power.sch, LEOLED]

Parts:
C1, C4, C5, C6, C7, C8, C11, C23: 1uF; C_0603_1608Metric; Rating 16V; Tolerance 20% X7R; Manufacturer PN GRM188R71C105MA12D
C2, C10: 10uF; C_1206_3216Metric; Rating 16V; Tolerance 10% X7R; Manufacturer PN CL31B106KOHZW6E
C3, C9, C12: 0.1uF; C_0603_1608Metric; Rating 16V; Tolerance 10% X7R; Manufacturer PN GRM188R71C104KA01D
D1: MBR120VLSFT1G; D_SOD-123FL; Rating 20V, 1A; Tolerance NA; Manufacturer PN MBR120VLSFT1G
D2: LTST-S270KRKT; LED_0603_1608Metric_Side_Mounted; Rating 20mA; Tolerance NA; Manufacturer PN LTST-S270KRKT
Q1, Q2: DMN65D8L-7; SOT-23; Rating 60V, 310mA; Tolerance NA; Manufacturer PN DMN65D8L-7
R1, R2, R3, R7, R16, R17, R25: 0; R_0603_1608Metric; Rating 0.1W; Tolerance 1%; Manufacturer PN CRG0603ZR
R4, R5, R6: 1M; R_0603_1608Metric; Rating 0.1W; Tolerance 1%; Manufacturer PN CRG0603F1M0
R8, R13, R32: 100k; R_0603_1608Metric; Rating 0.1W; Tolerance 1%; Manufacturer PN CRG0603F100K
R9: 5.62k; R_0603_1608Metric; Rating 0.1W; Tolerance 1%; Manufacturer PN ERJ-3EKF5621V
R10: 866; R_0603_1608Metric; Rating 0.1W; Tolerance 1%; Manufacturer PN ERJ-3EKF8660V
R11: 47k; R_0603_1608Metric; Rating 0.1W; Tolerance 1%; Manufacturer PN CRCW060347K0FKEAC
R12: 180k; R_0603_1608Metric; Rating 0.1W; Tolerance 1%; Manufacturer PN CRCW0603180KFKEA
R14: 1.2M; R_0603_1608Metric; Rating 0.1W; Tolerance 1%; Manufacturer PN RC0603FR-071M2L
R15: 1.8M; R_0603_1608Metric; Rating 0.1W; Tolerance 1%; Manufacturer PN RC0603FR-071M8L
R30: 1k; R_0603_1608Metric; Rating 0.1W; Tolerance 1%; Manufacturer PN CRG0603F1K0
R31: 270k; R_0603_1608Metric; Rating 0.1W; Tolerance 1%; Manufacturer PN RC0603FR-07270KL
TH1: 100k_NTC_TH; R_0603_1608Metric; Rating NA; Tolerance 1%; Manufacturer PN NTCG164KF104FT1
TP1, TP2, TP3, TP4, TP5, TP6, TP7, TP8, TP9, TP10, TP11, TP12, TP13: Test_Point; TestPoint_Pad_D1.5mm; Rating NA; Tolerance NA; Manufacturer PN NA
U1: BQ24210; WSON-10-1EP_2x3mm_Pitch0.5mm_ThermalVias; Rating 7V; Tolerance NA; Manufacturer PN BQ24210DQCT
U2: MAX1725; SOT-23-5; Rating 12V; Tolerance NA; Manufacturer PN MAX1725EUK+T

Connections:
/BLE/ADC_I_CHRG: C7.1, R11.1, TP7.1; also elsewhere on the board
/BLE/ADC_V_BATT: C23.1, R31.2, R32.1, TP13.1; also elsewhere on the board
/LED_Driver/BATT_VDD: C4.1, C8.1, C9.1, C10.1, R13.2, R31.1, TP8.1, U1.10 (BAT), U2.1 (IN); also elsewhere on the board
/Power/BQ_CHG: R3.2; also elsewhere on the board
/Power/BQ_EN: R1.2; also elsewhere on the board
/Power/BQ_PG: R2.2; also elsewhere on the board
/Power/NTC_N: Q2.3 (D), R17.2, TH1.2, TP12.1; also elsewhere on the board
/Power/NTC_P: C5.1, R12.2, TH1.1, TP11.1, U1.5 (TS); also elsewhere on the board
/Power/SOLAR_VDD: C1.1, C2.1, C3.1, D1.1 (K), TP6.1, U1.1 (VBUS); also elsewhere on the board
/Power/VUSB: D1.2 (A), Q1.1 (G), Q2.1 (G), R8.1, TP1.1; also elsewhere on the board
/Power/~CHG: D2.1 (K), R3.1, R6.2, TP5.1, U1.8 (~CHG)
/Power/~PG: R2.1, R5.2, R7.1, TP4.1, U1.6 (~PG)
unnamed: C6.1, R12.1, U1.4 (VTSB)
unnamed: D2.2 (A), R30.2
unnamed: Q1.3 (D), R9.2
unnamed: R1.1, R4.2, R7.2, TP3.1, U1.7 (~EN)
unnamed: R10.1, R11.2, U1.2 (ISET)
unnamed: R13.1, U2.5 (~SHDN)
unnamed: R14.1, R15.2, U2.4 (FB)
unnamed: R15.1, R16.2
VDD: C11.1, C12.1, R4.1, R5.1, R6.1, R16.1, R30.1, TP10.1, U2.3 (OUT); also elsewhere on the board

Notes on the sheet:
450mA MAX I_CHRG
4.35V VDPM USB Battery Tracking SOLAR
AUTO ENABLE LOAD MODE DISABLED
3.10V
V_BATT scaling factor 2.7/3.7

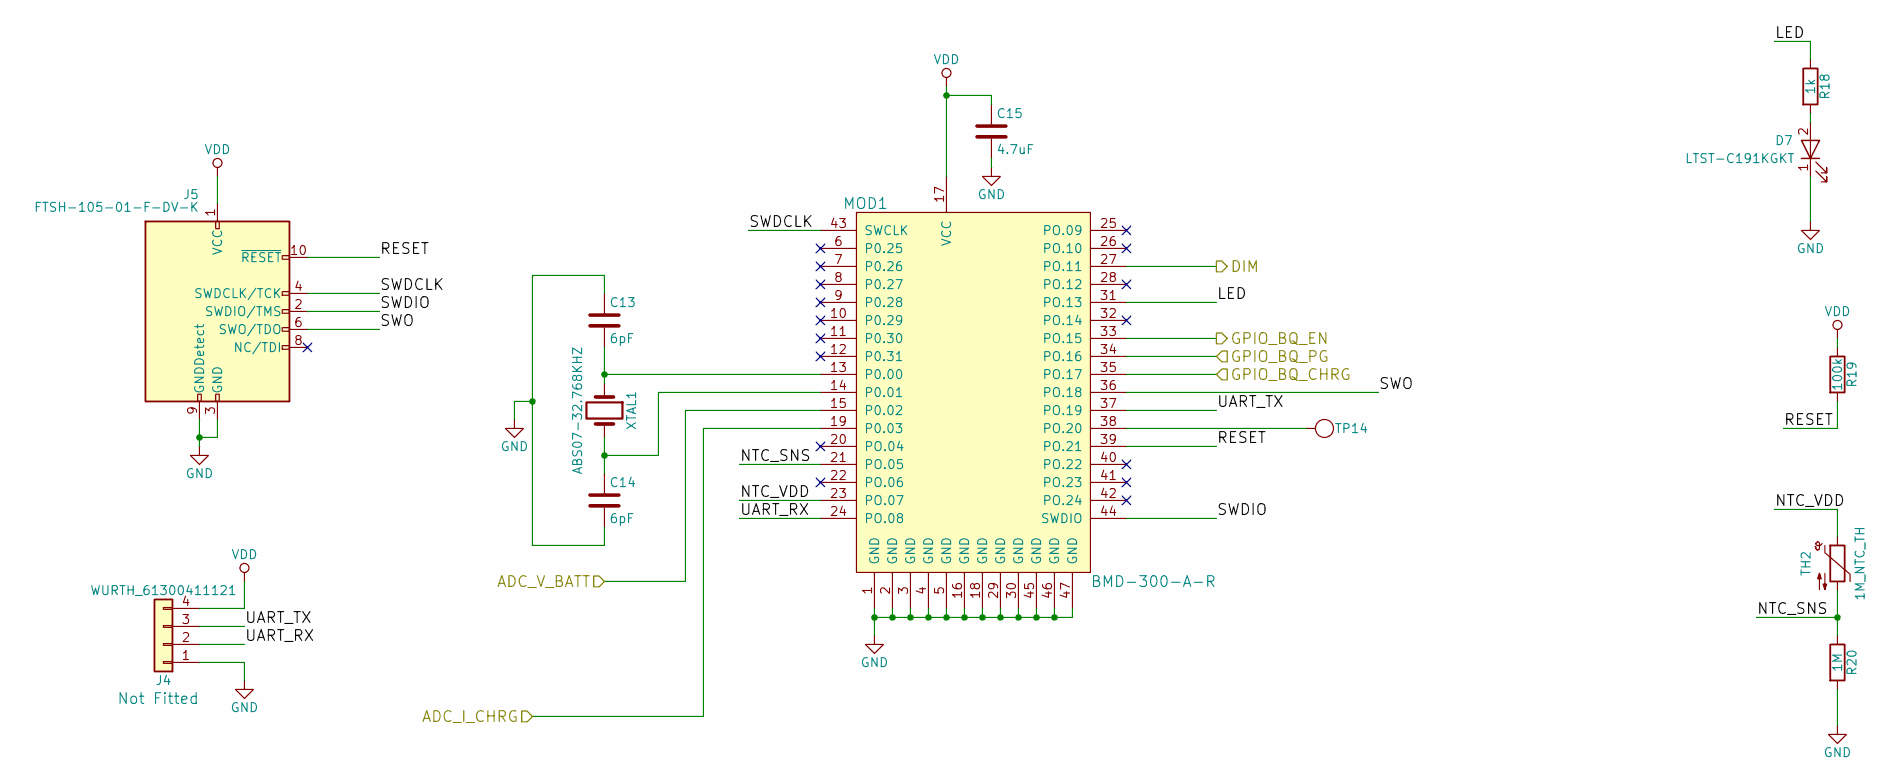
[picture p41: schematic BLE.sch, LEOLED]

Parts:
C13, C14: 6pF; C_0402_1005Metric; Rating 50V; Tolerance ±0.5pF; Manufacturer PN GRM1555C1H6R0DA01D
C15: 4.7uF; C_0603_1608Metric; Rating 16V; Tolerance 10% X5R; Manufacturer PN CL10A475KO8NNNC
D7: LTST-C191KGKT; LED_0603_1608Metric; Rating 20mA; Tolerance NA; Manufacturer PN LTST-C191KGKT
J4: WURTH_61300411121; Pin_Header_Straight_1x04_Pitch2.54mm; Rating NA; Tolerance NA; Manufacturer PN 61300411121
J5: FTSH-105-01-F-DV-K; Pin_Header_Straight_2x05_Pitch1.27mm_SMD; Rating NA; Tolerance NA; Manufacturer PN FTSH-105-01-F-DV-K
MOD1: BMD-300-A-R; BLE_Rigado_BMD-300; Rating 1.7V to 3V; Tolerance NA; Manufacturer PN BMD-300-A-R
R18: 1k; R_0603_1608Metric; Rating 0.1W; Tolerance 1%; Manufacturer PN CRG0603F1K0
R19: 100k; R_0603_1608Metric; Rating 0.1W; Tolerance 1%; Manufacturer PN CRG0603F100K
R20: 1M; R_0603_1608Metric; Rating 0.1W; Tolerance 1%; Manufacturer PN CRG0603F1M0
TH2: 1M_NTC_TH; R_0603_1608Metric; Rating 0.1W; Tolerance 3%, B25/50 4661K; Manufacturer PN NTCG164QH105HT1
TP14: Test_Point; TestPoint_Pad_D1.5mm; Rating NA; Tolerance NA; Manufacturer PN NA
XTAL1: ABS07-32.768KHZ; ABS07-32.768KHZ-7-T; Rating NA; Tolerance 20ppm; Manufacturer PN ABS07-32.768KHZ-7-T

Connections:
/BLE/ADC_I_CHRG: MOD1.19 (P0.03); also elsewhere on the board
/BLE/ADC_V_BATT: MOD1.15 (P0.02); also elsewhere on the board
/BLE/DIM: MOD1.27 (PO.11); also elsewhere on the board
/BLE/LED: MOD1.31 (PO.13), R18.1
/BLE/NTC_SNS: MOD1.21 (PO.05), R20.1, TH2.2
/BLE/NTC_VDD: MOD1.23 (PO.07), TH2.1
/BLE/RESET: J5.10 (~RESET~), MOD1.39 (PO.21), R19.2
/BLE/SWDCLK: J5.4 (SWDCLK/TCK), MOD1.43 (SWCLK)
/BLE/SWDIO: J5.2 (SWDIO/TMS), MOD1.44 (SWDIO)
/BLE/SWO: J5.6 (SWO/TDO), MOD1.36 (PO.18)
/BLE/UART_RX: J4.2, MOD1.24 (PO.08)
/BLE/UART_TX: J4.3, MOD1.37 (PO.19)
/Power/BQ_CHG: MOD1.35 (PO.17); also elsewhere on the board
/Power/BQ_EN: MOD1.33 (PO.15); also elsewhere on the board
/Power/BQ_PG: MOD1.34 (PO.16); also elsewhere on the board
unnamed: C13.2, MOD1.13 (P0.00), XTAL1.1
unnamed: C14.1, MOD1.14 (P0.01), XTAL1.2
unnamed: D7.2 (A), R18.2
unnamed: MOD1.38 (PO.20), TP14.1
VDD: C15.1, J4.4, J5.1 (VCC), MOD1.17 (VCC), R19.1; also elsewhere on the board

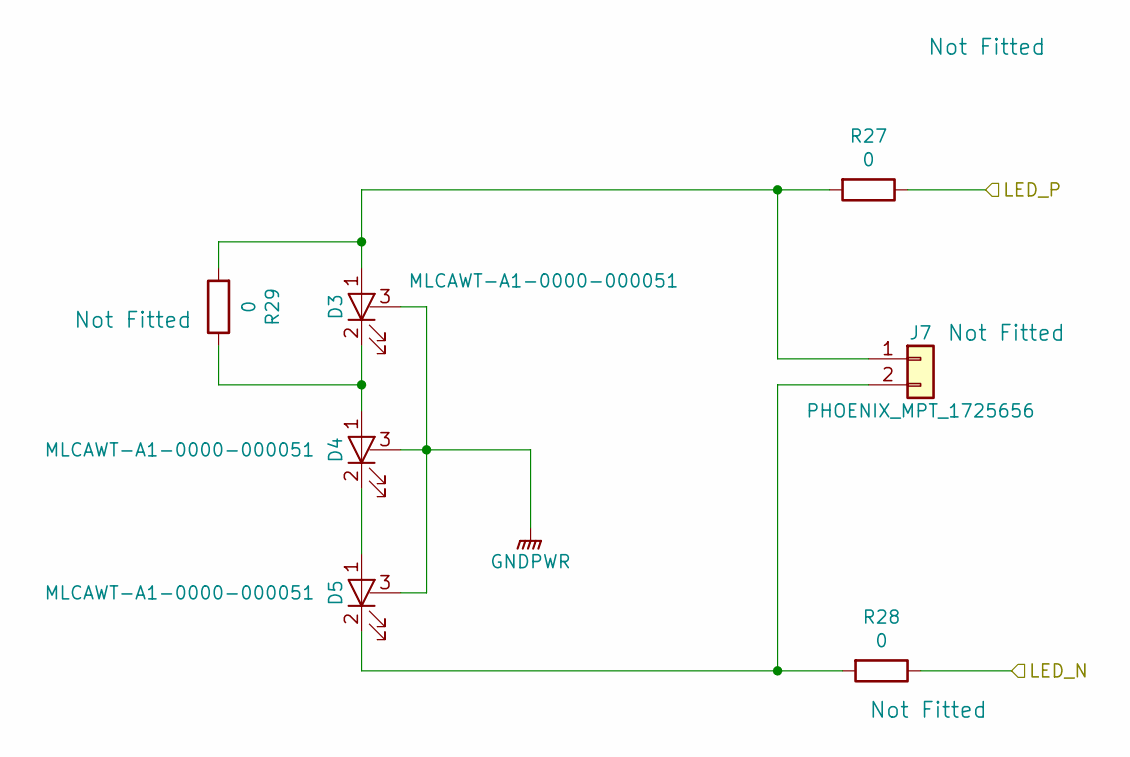
[picture p42: schematic LED.sch, LEOLED]

Parts:
D3, D4, D5: MLCAWT-A1-0000-000051; Cree_MLC; Rating 300mW; Tolerance NA; Manufacturer PN MLCAWT-A1-0000-000051
J7: PHOENIX_MPT_1725656; TerminalBlock_Pheonix_MPT-2.54mm_2pol; Rating 6A, 125V; Tolerance NA; Manufacturer PN 1725656
R27, R28, R29: 0; R_0805_2012Metric; Rating 0.125W; Tolerance NA; Manufacturer PN ERJ-6GEY0R00V

Connections:
/LED/LED_N: R28.1; also elsewhere on the board
GNDPWR: D3.3 (HS), D4.3 (HS), D5.3 (HS); also elsewhere on the board
unnamed: D3.1 (A), J7.1, R27.2, R29.2
unnamed: D3.2 (K), D4.1 (A), R29.1
unnamed: D4.2 (K), D5.1 (A)
unnamed: D5.2 (K), J7.2, R28.2

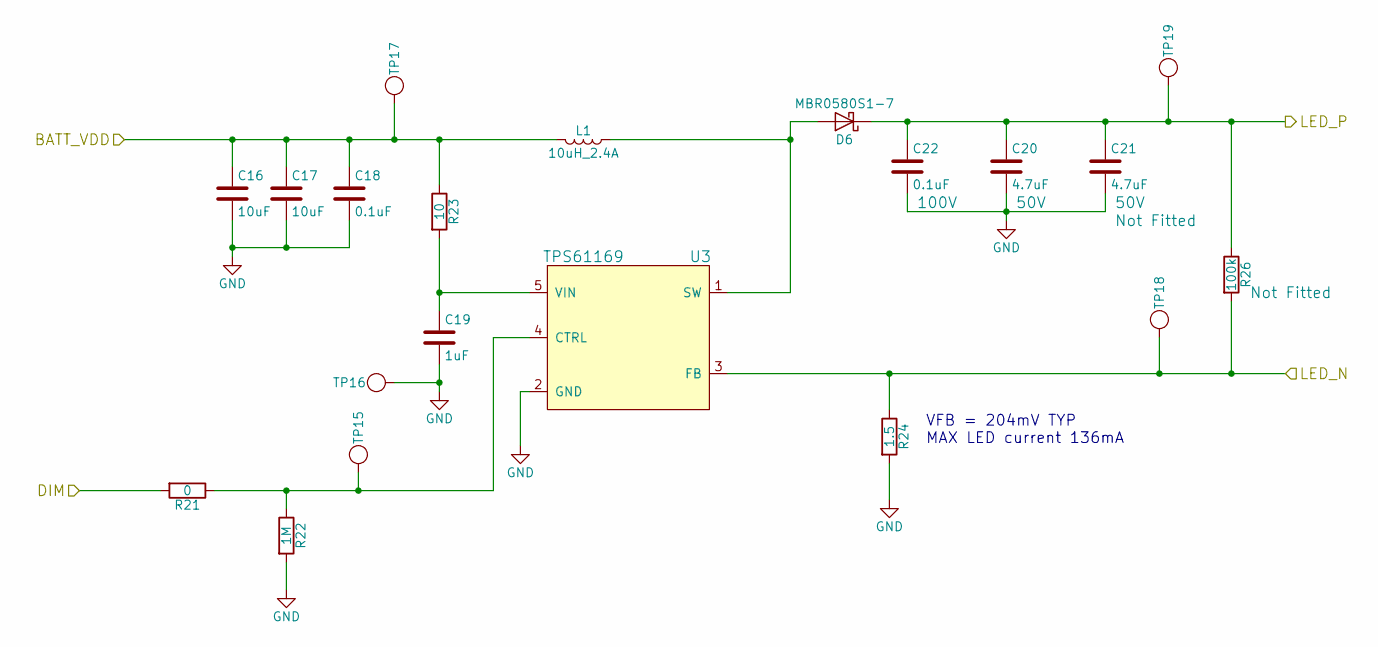
[picture p43: schematic LED_Driver.sch, LEOLED]

Parts:
C16, C17: 10uF; C_1206_3216Metric; Rating 16V; Tolerance 10% X7R; Manufacturer PN CL31B106KOHZW6E
C18: 0.1uF; C_0603_1608Metric; Rating 16V; Tolerance 10% X7R; Manufacturer PN GRM188R71C104KA01D
C19: 1uF; C_0603_1608Metric; Rating 16V; Tolerance 20% X7R; Manufacturer PN GRM188R71C105MA12D
C20, C21: 4.7uF; C_1206_3216Metric; Rating 50V; Tolerance X5R; Manufacturer PN CL31A475KB9LNNC
D6: MBR0580S1-7; D_SOD-123; Rating 500mA, 80V; Tolerance NA; Manufacturer PN MBR0580S1-7
L1: 10uH_2.4A; L_Wurth_5030; Rating 2.4A; Tolerance 20%; Manufacturer PN 74437336100
R21: 0; R_0603_1608Metric; Rating 0.1W; Tolerance 1%; Manufacturer PN CRG0603ZR
R22: 1M; R_0603_1608Metric; Rating 0.1W; Tolerance 1%; Manufacturer PN CRG0603F1M0
R23: 10; R_0603_1608Metric; Rating 0.1W; Tolerance 1%; Manufacturer PN AC0603FR-0710RL
R24: 1.5; R_0805_2012Metric; Rating 0.125W; Tolerance 1%; Manufacturer PN RC0805FR-071R5L
R25: 0.1uF; C_0805_2012Metric; Rating 100V; Tolerance 10%; Manufacturer PN GCM21BR72A104KA37L
R26: 100k; R_0603_1608Metric; Rating 0.1W; Tolerance 1%; Manufacturer PN CRG0603F100K
TP15, TP16, TP17, TP18, TP19: Test_Point; TestPoint_Pad_D1.5mm; Rating NA; Tolerance NA; Manufacturer PN NA
U3: TPS61169; TI_SC-70-5; Rating NA; Tolerance NA; Manufacturer PN TPS61169DCKR

Connections:
/BLE/DIM: R21.2; also elsewhere on the board
/LED/LED_N: R24.1, R26.2, TP18.1, U3.3 (FB); also elsewhere on the board
/LED_Driver/BATT_VDD: C16.1, C17.1, C18.1, L1.2, R23.1, TP17.1; also elsewhere on the board
unnamed: C19.1, R23.2, U3.5 (VIN)
unnamed: D6.2 (A), L1.1, U3.1 (SW)
unnamed: R21.1, R22.1, TP15.1, U3.4 (CTRL)

Notes on the sheet:
VFB = 204mV TYP MAX LED current 136mA

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
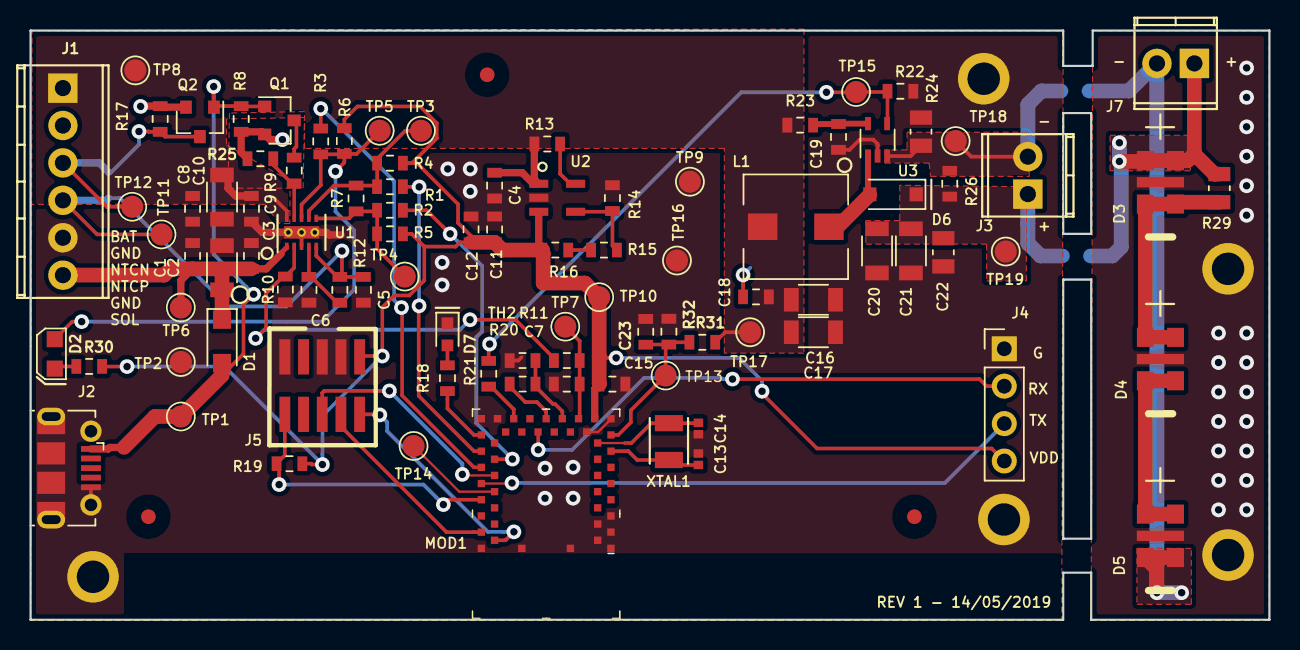
[picture p44: board LEOLED_rev1.kicad_pcb from above]

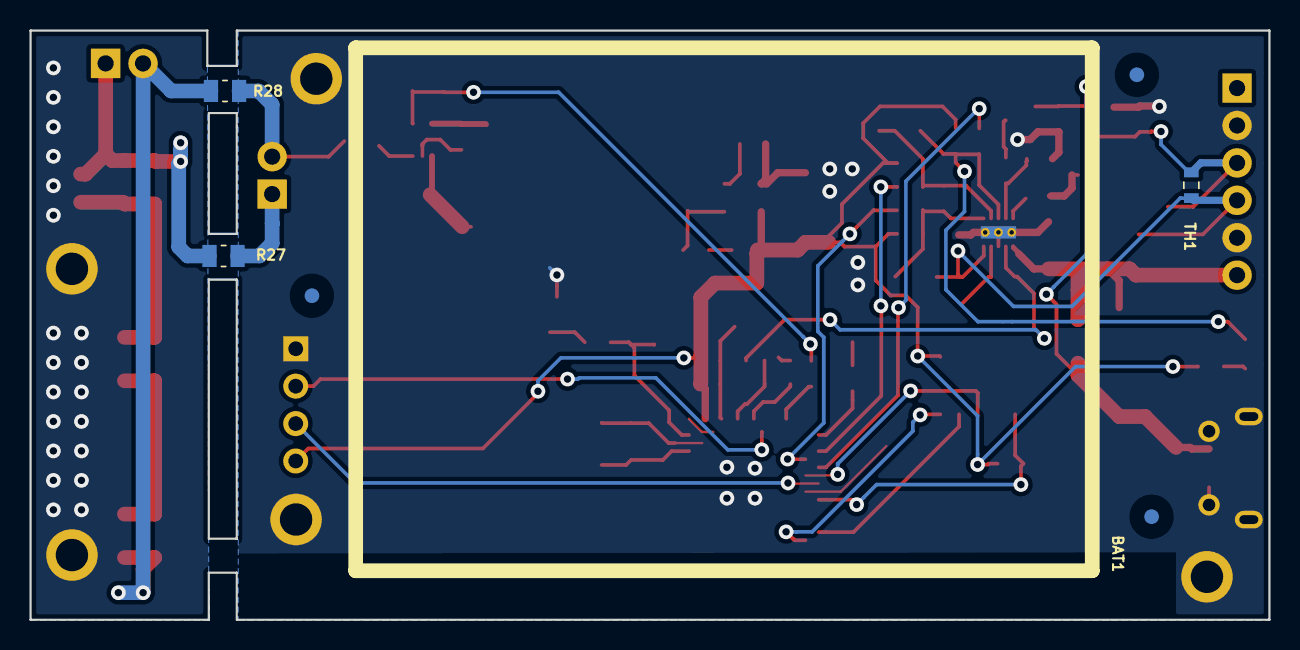
[picture p45: board LEOLED_rev1.kicad_pcb from below]

Board: 2 copper layers, 84.1 x 40.0 mm, 109 parts (7 on the bottom side), 47 nets.

Other parts of the board:
C22: 0.1uF; C_0805_2012Metric
FID1, FID2, FID3, FID4, FID5, FID6: Fiducial
